JulianYG/WNR/documentation/Pictures/Untitled-3.png

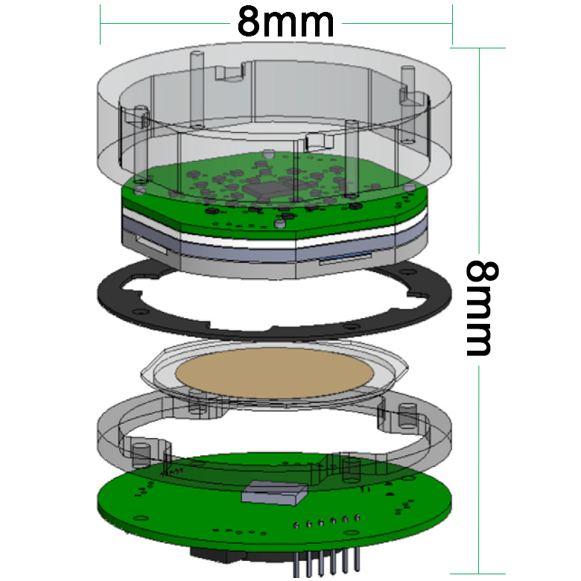
documentation/Pictures/Untitled-3.png
