JulianYG/WNR/documentation/Pictures/mockup.png

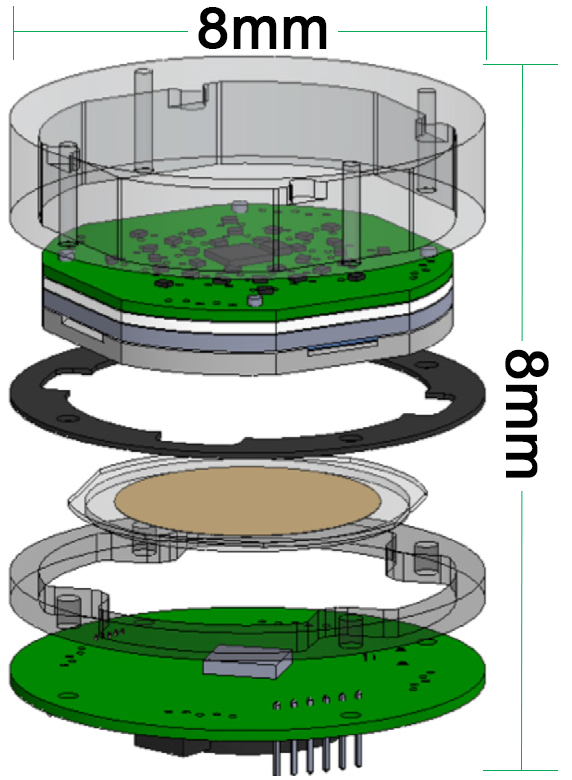
documentation/Pictures/mockup.png
