JulianYG/WNR/documentation/Pitches/Design Specifications.pptx

## Design Specifications

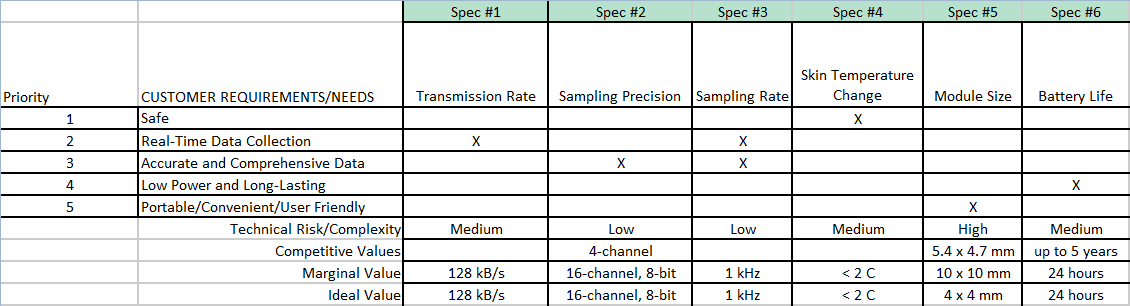
[picture p29: figure]

## Testing Methods

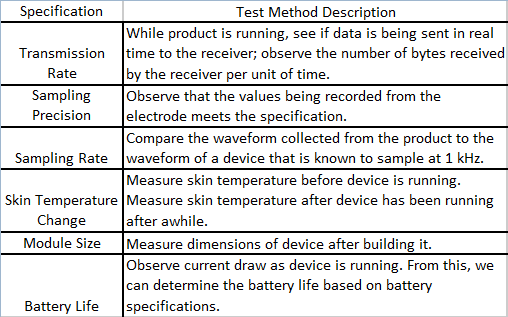
[picture p30: figure]

## System Diagram

## References

- http://www.neuropace.com/product/pdfs/UserManual.pdf
- Wireless Neural Recording with Single Low - Power Integrated Circuit (2010)
