JulianYG/WNR/documentation/Poster/Final Poster/WNR v6.pptx

Energy-Efficient High-Throughput Wireless Transmission of Multi-Channel Neural Signals

Wireless Neural Recorder - Senior Design Team
Yuan Gao, Xin Huang, Tingkai Liu, Stephen Xia
Department of Electrical and Computer Engineering, Rice University
ricewnr@gmail.com

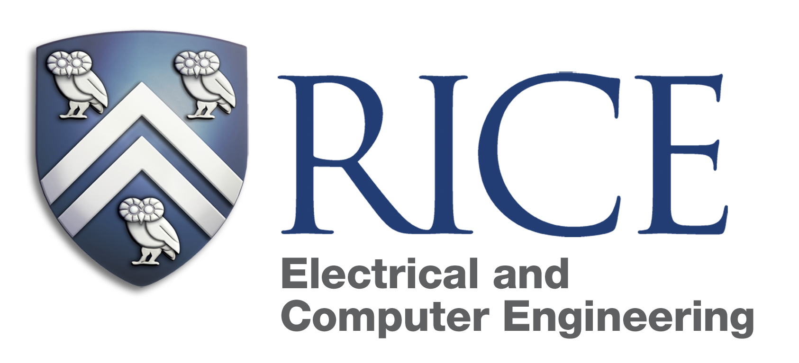
[picture p31: figure]

Project Description

Problem:
- Current Electrocochleography (ECoG) monitoring requires physical cables connected to brain to collect critical data for epilepsy diagnosis
- Lack of advanced wirelessly transmitting, implantable, monitoring devices hinder scientific progress and affect patient quality of life
System Design Goal:
- Create a compact, power-efficient, high-fidelity add-on cap to ECoG electrodes to wirelessly transmit neural data securely in real-time
Areas of Impact:
- Neurosurgeons & Hospitals – Simpler procedure and data monitoring
- Scientists & Research Institutions – Brain Machine Interface R&D
- Epilepsy Patients & their Families – Mobility and QOL improvement

Engineering Design for a Single WNR Cap

System Design Specifications

Design Requirements
Criteria | Target Value | Result
Data Channels | 16 Channels
Data Precision | 8 Bits
Sampling Frequency | 1000 Samples per Second
Form Factor | 15 x 15 x 15 mm
Battery Life | 12 Hours

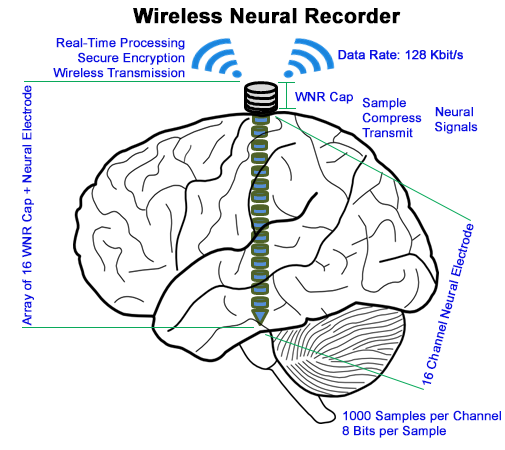
[picture p32: figure]

Neural Data

Neural Electrode
- 16 Data Channels
- 1K Samples/sec
- 8 Bits/Sample
Data: 128 Kbit/s

A2D Converter

Intan RHD2132
- Specialized Neural Recording with Protective Circuitry
- NanoVolt Data Sampling Precision

ARM Microprocessor

Nordic NRF52
- Powerful ARM Cortex-M4 Processor
- Data Buffering and Compression

Bluetooth Low Energy

Nordic NRF52
- 128 bit AES Encryption
- 1 Mbit/s Bandwidth
- < 6mA Power Consumption

Recording Server

Mobile Device
- Communicates with all WNR Caps
- Real-time Neural Data Collection and Presentation

WNR System

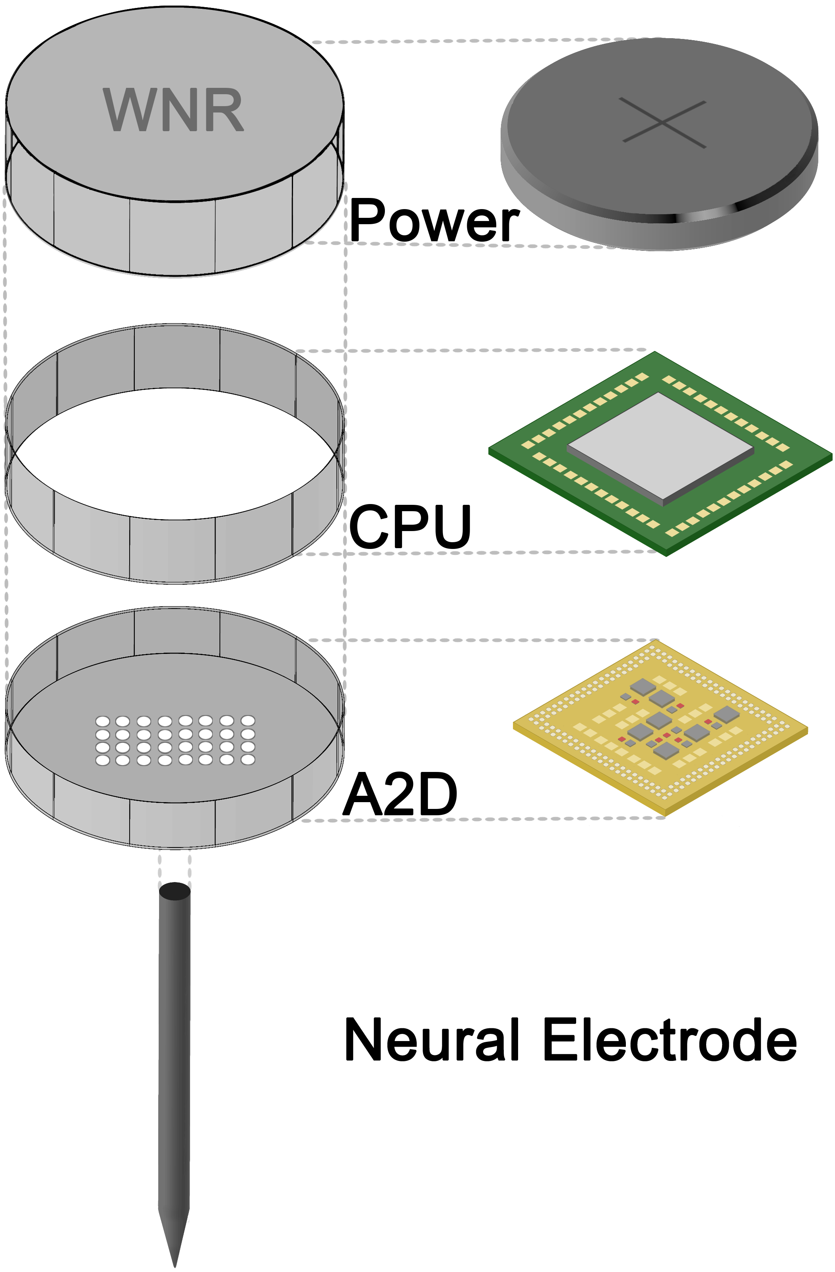
[picture p33: figure]

Conclusion

- Achieved goal of creating a compact, power-efficient, and precise Wireless Neural Recorder (WNR) and transmitter system, allowing neurosurgeons to obtain data while giving patients the freedom to move freely without being wired to a hospital bed

  - First generation system, with off-the-shelf components, achieves 50% data compression with sufficient excess compute power to integrate new software features such as epilepsy detection

Data:
- Available 32 Channel Sampling
- 1000 Samples per Second
- 8 Bit Data Precision

Small animal testing and data collection with functional prototype

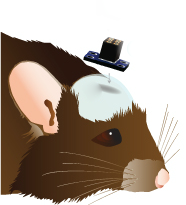
[picture p34: figure]

Power:
- Ultra-Low Power Consumption
- 12 Hour Battery Life
- 75mAh Off-the-Shelf Battery

Transmission:
- 1 Mbit/s Bandwidth
- 0.27 Mbit/s Throughput

Size & Safety:
- PCB size of 12x14 mm
- Integrated Protective Circuitry

Next Steps

Fabrication of custom components for smaller
8 x 8 x 8 mm design

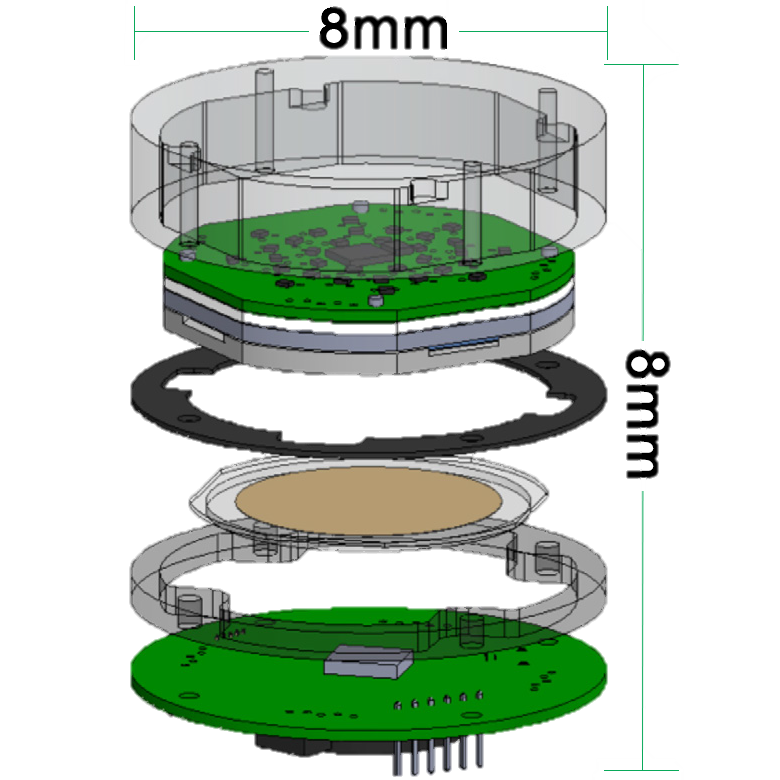
[picture p35: figure]

Utilize new WiFi HaLow for increased bandwidth, data rate, and data fidelity

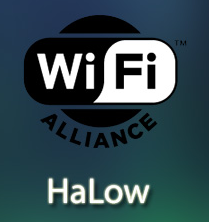
[picture p36: figure]

Expand WNR device to diagnose and monitor other diseases of the brain

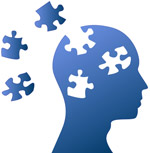
[picture p37: figure]

Acknowledgements

We would like to thank Rice ECE department members: Dr. Gary Woods, Dr. Aydin Babakhani, Hamed Rahmani and UTHealth Neurosurgeon: Dr. Nitin Tandon, for their technical advice and project support.
Special thanks to the Brenner Foundation with Ellen Kirk and the resources of the Oshman Engineering Design Kitchen.
