JulianYG/WNR/documentation/Minutes and Agendas/December 2015/reports/12-11 report.docx

WNR (Wireless Neural Recorder)

Rice University

Weekly Progress Report 13

12/4/2015 - 12/11/2015

Agenda for meetings

Cycle II Documentation Meeting:

1. Discuss new additions that are required
2. Divide up the documentation responsibility

Mentor Meeting:

1. Fall Design Review
  a. Recap on scope of project (design challenge, customer needs, etc.)
  b. Wireless Transmission
  c. Analog Front-End
  d. Compression
  e. Battery and Power

Activities this week

1. Analog Front-End:
  a. Discovered issue with reading in 0s.
    i. The number of pulses between Chip select pulses was not 16 (Intan sends 16-bits over SPI: 1 bit per pulse)
    ii. Must send data to the Intan Chip at the same time in order to read from the chip; otherwise no data is sent back
  b. Fed in data to the Intan Chip using a function generator with a voltage divider to characterize the chip.
    i. Fed data into one channel, but recorded data from all channels
  c. Measured and plotted power consumption
2. Wireless transmission:
  a. Discovered issue with stack initialization failure
    i. Jumper pins on the experimenter board were not configured correctly: every piece of documentation never mentioned this configuration except for the README file that came with the SDK that no one ever reads
  b. Bluetooth Connection Established
    i. Single slave to single master
    ii. Multiple slaves to single master
  c. Data Streaming Established
    i. Can stream from one slave to one master
    ii. Can also stream from two slaves to one master
  d. Transmission rate characterized
  e. Power consumption (current draw) measured
3. Compression:
  a. Comparison of MP3 compression and ALZ77 with Huffman Encoding

Problems encountered

1. Analog Front-End
  a. Intan Chip/entire circuit is extremely unreliable
    i. Sometimes the circuit would short for no apparent reason. The problem would fix itself after leaving the system alone for awhile.
  b. The signal read from the Intan Chip is extremely noisy
    i. This could be due to the fact that there are many wires in the development circuitry that are exposed to the air
    ii. Input voltages are driven really low by a normal resistor, which is noisy by itself
  c. Wrong values were being read from the Chip, though after a while, the issue seemed to resolve itself.
2. Wireless Transmission:
  a. Establishing Bluetooth link and streaming for one client and one master did not translate automatically into being able to do the same for multiple clients and one master
  b. Power consumption was difficult to measure because the MSP430F5438 experimenter board is a closed-circuit by itself
    i. Finally found a pin that can be used to measure current draw.
  c. MATLAB does not realistically calculate the data rate of the packets being received.
    i. Even though if packets are being sent over an interval of 10 seconds, the terminal program run from MATLAB is supposedly receiving all the packets within a period of less than one second. This makes the resulting data rate calculation be an order of magnitude greater than what the client actually sent.

Time devoted to project this week

Name | Tasks Accomplished | Hours Spent
Stephen Xia | - TI MSP430F5438 + TI CC2564 Bluetooth development - Cycle II Documentation | 80
Tingkai Liu | - Intan RHD2000 series analog front-end development - Cycle II Documentation | 72
Xin Huang | - Cycle II Documentation | 10
Yuan Gao | - Compression Characterization - Cycle II Documentation | 17
| Team Total | 179

Meetings Minutes

Cycle II Documentation Meeting – 12/7/2015, 1:00PM - 2:00 PM

Attendees: Stephen Xia, Tingkai Liu, Xin Huang, Yuan Gao

Location: Brochstein Pavilion

Completed objectives:

I. Cycle 1.5 Specifications are just the High Priority specifications that the fall design review will be graded on
II. Responsibilities of new documents
  A. Cycle III Functional Specs: Stephen Xia
  B. Testing Plan and Results: Yuan Gao
  C. IRB Information: Xin Huang
  D. Team Safety Plan: Thomas
  E. Design Foundation Revision: Xin Huang
  F. Design Strategy Revision: Stephen Xia
  G. Web Documentation: Xin Huang
  H. SVN Archives: Thomas
III. Prepare for fall design review on 12/10/2015 in the evening.

Mentor Meeting – 12/11/2015, 3:00PM - 5:00 PM

Attendees: Stephen Xia, Tingkai Liu, Xin Huang, Yuan Gao, Gary Woods, Hamed Rahmani, Nitin Tandon

Location: OEDK 104

Completed objectives:

I. Analog Front-End:
  A. Voltage rail issue resolved:
    1. The addition of the RHD2000 + LVDS converter was pulling the voltage supplied from the FreeScale Freedom board’s voltage to 0.
      a) Will power from an external power source
  B. 0s are still being read out
    1. SPI communication does not seem to be working still.
    2. Will try writing to the chip and observing what happens
II. Wireless Transmission
  A. Downgrading the IDE seems to have solved the issue of not being able to compile and load the demo code onto the boards.
  B. However, the demos don’t work because the MSP430F5438 cannot initialize the Bluetopia Bluetooth stack.
    1. upon further inspection, the MSP5438 does not seem to see the CC2564
  C. Will have to keep debugging; will have updates for the final design review.
III. Compression:
  A. The data received from Rakesh is very confusing
  B. Dr. Tandon looked at data and concludes that Rakesh has already processed the data.
    1. Dr. Tandon says he will get raw data to us in the next few days
IV. Items requested by Dr. Nitin Tandon
  A. Document of all the specifications, problems, and constraints.
    1. Include the calculation of power for all different specifications (e.g. what is power if we use Bluetooth, transmitting at 1 Mbps, etc.)
    2. Create an equation of power based on different frequency parameters
    3. Include a dream list or ideal list of specifications and parts

Expenditures

Action items list

Action item | Owner | Due date | Status
Research compression algorithms | Yuan Gao | 12/11/2015 | 75%
TI MSP430F5438 + TI CC2564 Bluetooth Development | Stephen Xia | 12/11/2015 | 70%
Intan RHD2000 series development | Tingkai liu | 12/11/2015 | 70%
Cycle Three Functional Specs | Stephen Xia | 12/14/2015 | 100%
Testing Plan and Results | Yuan Gao | 12/14/2015 | 100%
IRB Information | Xin Huang | 12/14/2015 | 100%
Team Safety Plan | Tingkai Liu | 12/14/2015 | 100%
Revisions to Previous Documents | Xin Huang | 12/14/2015 | 100%

Additional Comments/Questions for Mentors

- Dr. Tandon was actually able to turn up by 3:30 PM
- Dr. Woods had an appointment the previous day, so the meeting was pushed from 12/10/2015 to 12/11/2015
