JulianYG/WNR/documentation/Minutes and Agendas/December 2015/reports/12-3 report.docx

WNR (Wireless Neural Recorder)

Rice University

Weekly Progress Report 12

11/25/2015 - 12/3/2015

Agenda for meetings

Mentor Meeting:

1. Analog front-end updates with Intan Chip and LVDS converter.
2. Issues with MSP430F5438A in wireless communications.
3. Compression Updates

Activities this week

1. The wires on the Intan Adapter did not have pinouts, so we returned the adapter to Intan, who then shipped out the pinout adapter board.
2. Intan Chip power issue discovered and resolved.
  a. The Intan Chip + LVDS was pulling the voltage rail on the FreeScale Freedom board to ground.
    i. We are temporarily using the Freedom board for AFE development due to a lack of TI components and ease of use.
  b. For now, we will power the LVDS and Intan Chip from an external power supply
3. TI MSP430F5438 + TI CC2564 development is continuing.
  a. Changing IDE environments and re-downloading the SDK allows the code to compile and be loaded on the MCU
4. Received ECoG data from Rakesh; can test compression on live data.

Problems encountered

1. SPI communication with Intan Chip is still not working.
  a. Although the power issue is resolved, 0s are still only being read out.
2. TI CC2564 + TI MSP430F5438 Bluetopia Bluetooth SDK cannot be initialized on the MSP
  a. The error seems to stem from the fact that the MSP430F5438 does not seem to see the CC2564; however there are no leads as to why this is the case
  b. Will have to keep debugging and looking around.
  c. If this issue cannot be resolved in a timely manner, then we can switch to a simpler board for prototyping purposes.
3. ECoG data from Rakesh is very confusing and has many variables; we do not know which variable or file contains the actual data.

Time devoted to project this week

Name | Tasks Accomplished | Hours Spent
Stephen Xia | - TI MSP430F5438 + TI CC2564 Bluetooth development | 9
Tingkai Liu | - Intan RHD2000 series analog front-end development | 9
Xin Huang | - TI MSP430F5438 + TI CC2564 Bluetooth development | 4
Yuan Gao | - Huffman Encoding/Compression test and effectiveness characterization | 4
| Team Total | 26

Meetings Minutes

Mentor Meeting – 12/3/2015, 12:30PM - 1:30 PM

Attendees: Stephen Xia, Tingkai Liu, Xin Huang, Yuan Gao, Gary Woods, Hamed Rahmani, Nitin Tandon

Location: OEDK Big Classroom

Completed objectives:

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

Expenditures

- 1 x C3420 RHD2000 wire adapter for 36-pin connector (Returned): -$190
- 1 x C3410 RHD2000 electrode adapter board for 36-pin connector: $255
- Total: $65

Action items list

Action item | Owner | Due date | Status
Research compression algorithms | Yuan Gao | 12/11/2015 | 70%
TI MSP430F5438 + TI CC2564 Bluetooth Development | Stephen Xia | 12/11/2015 | 5%
Intan RHD2000 series development | Tingkai liu | 12/11/2015 | 10%

Additional Comments/Questions for Mentors

- Dr. Tandon mentions that he will not be able to attend the fall design review scheduled for next week.
