JulianYG/WNR/documentation/Minutes and Agendas/March 2016/reports/3-17 report.docx

WNR (Wireless Neural Recorder)

Rice University

Weekly Progress Report 22

3/11/2016 - 3/17/2016

Agenda for meetings

Mentor Meeting:

1. PCB Issues
2. Issues with Merging Subsystems

Activities this week

1. Most of PCB design is finished
2. Merging Subsystems

Problems encountered

1. Spacing is very tight on PCB
2. Difficulty in combining compression and spi reading with event handler

Time devoted to project this week

Name | Tasks Accomplished | Hours Spent
Stephen Xia | - Merging Subsystems | 15
Tingkai Liu | - Intan PCB Design | 15
Xin Huang | - Nordic PCB Design | 15
Yuan Gao | - Merging Subsystems | 10
| Team Total | 55

Meetings Minutes

Weekly Meeting – 3/17/2016, 12:00PM - 1:00 PM

Attendees: Stephen Xia, Tingkai Liu, Xin Huang, Yuan Gao, Gary Woods

Location: OEDK 104

Completed objectives:

I. Battery:
  A. P13: doesn’t work:
    1. Less than 3.0 V
  B. Alternatives:
    1. Larger pr44 that has enough voltage is too big (the battery holder) to fit on board with the jumpers
    2. Could make custom battery holder
    3. Or smush parts together
II. Nordics out of stock
  A. Order older revisions
III. Revisions and finalize PCB:
  A. Reduce spacing between pins
IV. Nordic: merging subsystems
  A. Trying to get event handler to do compression and read at the same time; may take a while
  B. Eventually will need to add ble

Expenditures

- N/A

Action items list

Action item | Owner | Due date | Status
Nordic PCB Design | Xin Huang | 4/14/2016 | 60%
Intan PCB Design | Tingkai Liu | 4/14/2016 | 60%
Combine compression, spi, and transmission | Stephen | 4/14/2016 | 20%
Server/Receiver | Yuan Gao | 4/14/2016 | 10%

Additional Comments/Questions for Mentors
