JulianYG/WNR/documentation/Minutes and Agendas/October 2015/reports/10-29 report.docx

WNR (Wireless Neural Recorder)

Rice University

Weekly Progress Report 8

10/23/2015 - 10/29/2015

Agenda for meetings

Mentor Meeting:

1. Go over power consumption and bandwidth feasibility with Dr. Tandon
2. CC2650 wireless transmission updates
3. Discuss how to pay for the Intan Chip using funds from two different sources
4. Discuss how to obtain intracranial EEG data

Activities this week

1. Continue development of wireless transmission scheme using CC2650 and Nordic Labs boards

Problems encountered

1. Working on CC2650 is still slow; still trying to understand code and documentation
2. Nordic Labs SDK still not set up

Time devoted to project this week

Name | Tasks Accomplished | Hours Spent
Stephen Xia | - CC2650 BLE development | 5
Tingkai Liu | - Confirm Intan Chip specifications and costs - CC2650 BLE development | 5
Xin Huang | - Finish battery research - Nordic Board BLE development | 5
Yuan Gao | - Nordic Board BLE development | 5
| Team Total | 20

Meetings Minutes

Mentor Meeting – 10/29/2015, 12:30PM - 1:30 PM

Attendees: Stephen Xia, Tingkai Liu, Xin Huang, Yuan Gao, Gary Woods, Hamed Rahmani

Completed objectives:

I. Dr. Tandon did not show up, so we did not present our power and bandwidth feasibility
II. Buying the Intan Chip:
  A. Require funding from two sources (ECE department and OEDK)
    1. We can place the order in one department and transfer funds between departments
III. CC2650:
  A. Figured out the general framework of CC2650
  B. Aim to have something custom transmitting next week
  C. Probably has enough memory to run a compression algorithm
IV. EEG Data:
  A. No response from Dr. Tandon or Behnaam
    1. Talk to them directly or their graduate students, who should have data
V. Compile a list of questions to ask Dr. Tandon
  A. How low can we sample the data?
    1. Most papers only display up to 30 Hz on the spectrum
    2. If we lower the sampling rate to around 250 Hz, we can get the data rate to around 0.5 Mb/s, which is supported by BLE.
      a) Otherwise, we may have to heavily compress the data
  B. Can we get physical needle?
VI. FOSS II Goals:
  A. Characterize maybe only one environment
  B. Possibly require an error correction mechanism (TCP or error correction code)
VII. For Next Time:
  A. Order the Intan AFE Chip
  B. Create Slides for Dr. Tandon next week
  C. Obtain EEG data and run compression algorithms to test efficiency
  D. Get transmission and incorporate Intan Chip

Expenditures

- N/A

Action items list

Action item | Owner | Due date | Status
Survey analog front-end chips for neural recording | Tingkai Liu | 10/29/2015 | 100%
Research analog front-end circuits for high SNR amplification | Stephen Xia | 10/29/2015 | 100%
Battery module research/survey | Xin Huang | 10/23/2015 | 100%
Intan Chip/Analog front-end power consumption research | Tingkai Liu | 10/23/2015 | 50%
Wireless transmission power consumption research | Stephen Xia | 10/23/2015 | 50%
Research compression algorithms | Yuan Gao | 10/23/2015 | 30%
CC2650/CC2640 BLE Development | Xin Huang | 10/23/2015 | 40%
Nordic Labs BLE Development | Tingkai Liu | 11/04/2015 | 10%

Additional Comments/Questions for Mentors
