JulianYG/WNR/documentation/Cycle II Documentation/web_documentation_cycle2.pdf

12/14/2015 | OEDK Rice University Member public profile

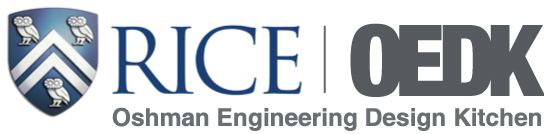
[picture p52: figure]

http://oedk.rice.edu/Sys/PublicProfile/29809194/1063096 | 1/3
Events (http://oedk.rice.edu/events) | News (http://oedk.rice.edu/news) | FAQs (http://oedk.rice.edu/faqs) | Get Involved (http://oedk.rice.edu/getinvolved)
Enter search string |

Membership level

Team Name

Project Title

Design Challenge

Project Thumbnail Image

Date Updated

Sponsors

Department(s)

Faculty Advisor 1 - Name

Faculty Advisor 1 - Department

Faculty Advisor 2 - Name

Faculty Advisor 2 - Department

Rapid Prototyping Tools Used

Back (http://oedk.rice.edu/projects)

# WNR

# Wireless Relay of Multi-Channel Neuro-Electrode Data

Send message

2015-2016 Team

WNR

Wireless Relay of Multi-Channel Neuro-Electrode Data

Currently, no solution exists on the market for an efficient recording of neural brain activity that is not restricted by a physical tether. Our project goal is to develop a low-power wireless recording device that digitizes neural signals from a 16-channel, 16-element electrode array and send the neural data wirelessly to a portable receiver. The wireless neural recorder will first be wireless embedded ECoG system implemented in animals and eventually humans.

Sunday, December 13, 2015

Brenner Foundation with Ellen Kirk

Electrical and Computer Engineering

Gary Woods

ECE

Aydin Babakhani

ECE

PCB Mill
Reflow Oven
Soldering Station
Oscilloscope

Facilities Used

Electronic Tools Used

Software Used

PROPER ACKNOWLEDGMENT:

Hand Tools

Conference Rooms
Computer Lab or Computer Nook Specialty Software
Printers/ Copiers
Electronics Lab or Tools from Electronics Lab

TI Microcontroller (MSP 430)
TI DSP Chip (eg C2000)
Arduino
ARM
Hand assembled Protoboard/perf board Prefabricated PCB (eg evaluation modules, LaunchPAd FPGA
Freescale
LED
LCD display
Digital Multi-meter

C
C++
Matlab
Eagle
Code Composer

This project was sponsored by Brenner Foundation with Ellen Kirk. The design work for this project was supported by the resources of the Oshman Engineering Design Kitchen.

# Member photo albums (2 Albums)

Team Photo Album (3) (http://oedk.rice.edu/Sys/PublicProfile/29809194/PhotoAlbums/46020854) | Team Photo Album 2 (5) (http://oedk.rice.edu/Sys/PublicProfile/29809194/PhotoAlbums/47834308)

# ABOUT

Mission (http://oedk.rice.edu/what)
Our Team (http://oedk.rice.edu/people)
Visit the OEDK (http://oedk.rice.edu/where)
Curriculum (http://oedk.rice.edu/curriculum)
Immersion (http://oedk.rice.edu/immersion)
Programs (http://oedk.rice.edu/programs)

# QUICK LINKS

Current Projects (http://oedk.rice.edu/projects)
Award Winning Projects (http://oedk.rice.edu/winners)
Project Videos (http://oedk.rice.edu/videos)
Project Sponsors - coming soon Tour Request (http://oedk.rice.edu/tour)
Safety Guidelines (http://oedk.rice.edu/safetyguidelines)

# RICE PARTNERS

Rice University Homepage (http://www.rice.edu/)
Brown School of Engineering (http://engr.rice.edu/) Rice Center for Engineering Leadership (http://rcel.rice.edu/)
Beyond Traditional Borders (http://www.rice360.rice.edu/btb)
Rice 360˚ Institute for Global Health (http://www.rice360.rice.edu/)

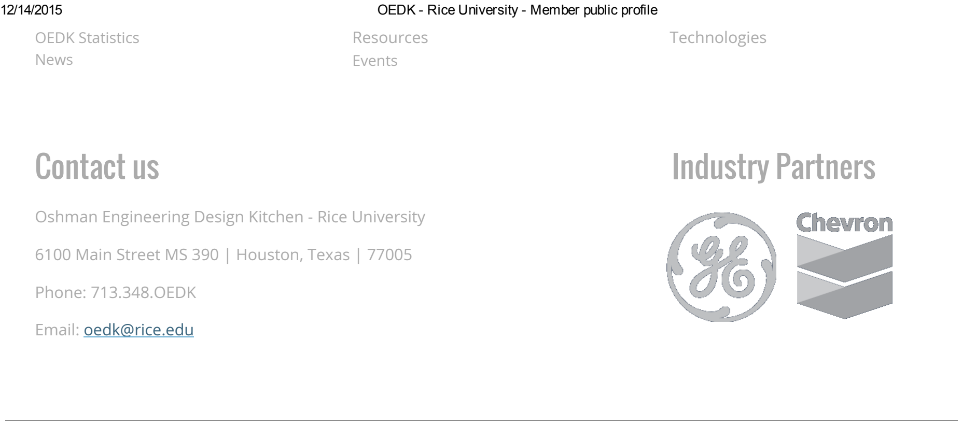
[picture p53: figure]
OEDK Statistics News; Resources Events; Technologies; Contact us; Phone: 713.348.OEDK; Email: oedk@rice.edu; Industry Partners

Oshman Engineering Design Kitchen - Rice University

6100 Main Street MS 390 | Houston, Texas | 77005

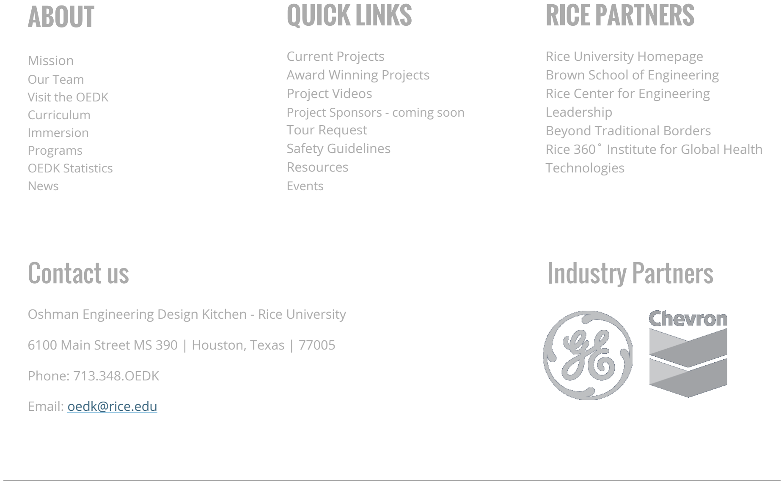
[picture p54: figure]
ABOUT; Mission Our Team Visit the OEDK Curriculum Immersion Programs OEDK Statistics News; QUICK LINKS; Current Projects Award Winning Projects Project Videos Project Sponsors - coming soon Tour Request Safety Guidelines Resources Events; RICE PARTNERS; Rice University Homepage Brown School of Engineering Rice Center for Engineering Leadership Beyond Traditional Borders Rice 360˚ Institute for Global Health Technologies; Contact us; Phone: 713.348.OEDK; Email: oedk@rice.edu; Industry Partners

http://oedk.rice.edu/Sys/PublicProfile/29809194/PhotoAlbums/47834308 | 1/1
Events (http://oedk.rice.edu/events) | News (http://oedk.rice.edu/news) | FAQs (http://oedk.rice.edu/faqs) | Get Involved (http://oedk.rice.edu/getinvolved)
Enter search string |

Back (http://oedk.rice.edu/Sys/PublicProfile/29809194/1063096)

# Team Photo Album 2 (5)

Created on: Sunday, December 13, 2015

Cycle 2

Oshman Engineering Design Kitchen - Rice University

6100 Main Street MS 390 | Houston, Texas | 77005
