JulianYG/WNR/documentation/Cycle II Documentation/Functional Specifications Cycle III.xlsx

Team: WNR
Stephen Xia
Tingkai Liu
Yuan Gao
Xin Huang
Cycle III: Functional Specifications
 |  | Spec #1 | Spec #2 | Spec #3 | Spec #4 | Spec #5 | Spec #6 | Spec #7 | Spec #8
Priority | CUSTOMER REQUIREMENTS/NEEDS | Transmission Rate | Sampling Precision | Sampling Rate | Skin Temperature Change | Module Size | Battery Life | Operable Range | DC Offset
1 | Safe |  |  |  | X |  |  |  | X
2 | Real-Time, Accurate, and Reliable | X | X | X |  |  |  |  | X
3 | Portable/Convenient/Low Power |  |  |  |  | X | X | X
 | Technical Risk/Complexity | Medium | Low | Low | Medium | High | Medium | Medium | Medium
 | Competitive Values | 15 Mb/s | 64-channel, 10-bit | 100 kHz | < 2 C / 3.6 F | 5.4 x 4.7 mm | up to 5 years | 4 meters | 1 - 2 V | TOTALS (Should sum to 2000 with Cycle 4/5 objectives)
 | Marginal Value | 128 kb/s/electrode | 16-channel, 8-bit | 1 kHz | < 2 C / 3.6 F | 10 x 10 mm | 6 hours | 2 meters | 0 - 2 V
 | Ideal Value | 256 kb/s/electrode | 16-channel, 16-bit | 1 kHz | < 1 C / 1.8 F | 4 x 4 mm | few years | 4 meters | 0 - 1 V
 | Final Measured Value (Cycle 5)
 | Potential Point Value (Students Enter) |  |  |  |  |  |  |  |  | 0
 | Graded Point Value (Profs Enter) |  |  |  |  |  |  |  |  | 0
Objectives for Cycle III
Related Specifications | Objective |  |  |  | Potential Points (<300) | Graded Points
Spec 1, 2, 3, 6 | 1. Analog Front-End & Bluetooth
 | 1.1. Read data from SPI |  |  |  | 400
 | 1.2. Buffer read data and continuously transmit buffered data from at least two wireless chips (peripherals) to a receiver at the same time |  |  |  | 400
 | 1.3. Measure power consumption of running the wireless transmission component and data pre-processing at the same time, transmitting at 1000 samples/s/channel for at least 16 channels (16,000 samples/s total) |  |  |  | 200
Spec 2, Spec 3, Spec 6 | 2. Server End
 | 2.1. Receive data packet from at least two wireless chips within operable range, potentially perform error correction |  |  |  | 500
 | 2.2. Marshal the data by parsing headers and footers in real time (order the data received into sequence based on time stamp and probe header) |  |  |  | 200
 | 2.3. Generate real time plot and/for display |  |  |  | 150
Spec 1 | 3. Compression and Data Analysis
 | 3.1. Implement the ALZ77 compression algorithm on microcontroller and evaluate feasibility |  |  |  | 150
 | TOTAL |  |  |  | 2000
