JulianYG/WNR/documentation/Cycle III Documentation/K_EngineeringDrawings_WNR_Cycle 3.docx

Figure 1. System Block Diagrams which shows each component of the complete system

Figure 2. nRF52 memory map.

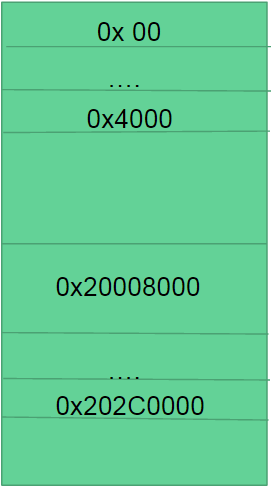
[picture p55: figure]

ROM: 0x0 - 0x4000, RAM: 0x20008000 - 0x202C0000

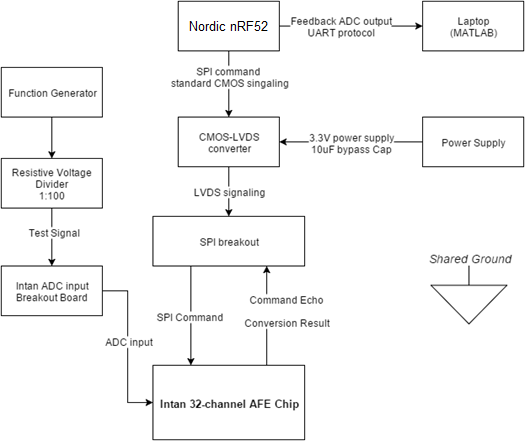
[picture p56: figure]

Figure 3. Complete System Setup for configuration and testing of Intan RHD2132 Analog-Front-End Chip
