JulianYG/WNR/documentation/Cycle III Documentation/Intan32_powerconsumption.png

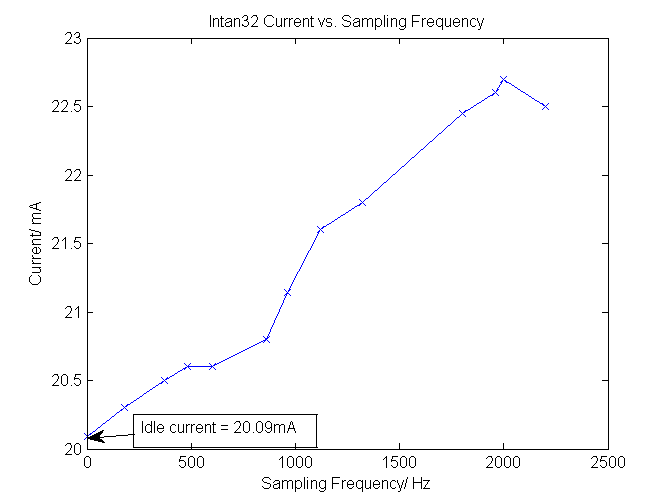
documentation/Cycle III Documentation/Intan32_powerconsumption.png
