JulianYG/WNR/documentation/Pictures/a32.png

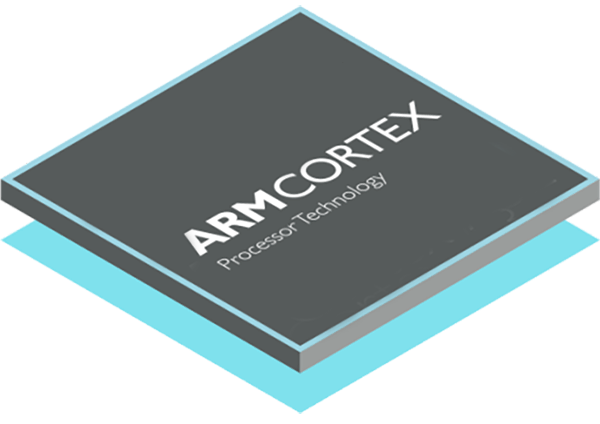
documentation/Pictures/a32.png
