JulianYG/WNR/documentation/Pictures/graphic.png

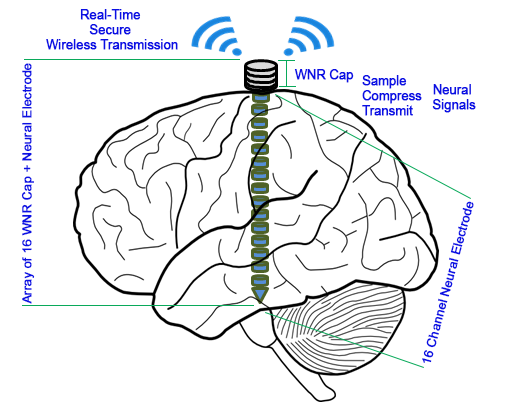
documentation/Pictures/graphic.png
