JulianYG/WNR/documentation/Pictures/Untitled-1.png

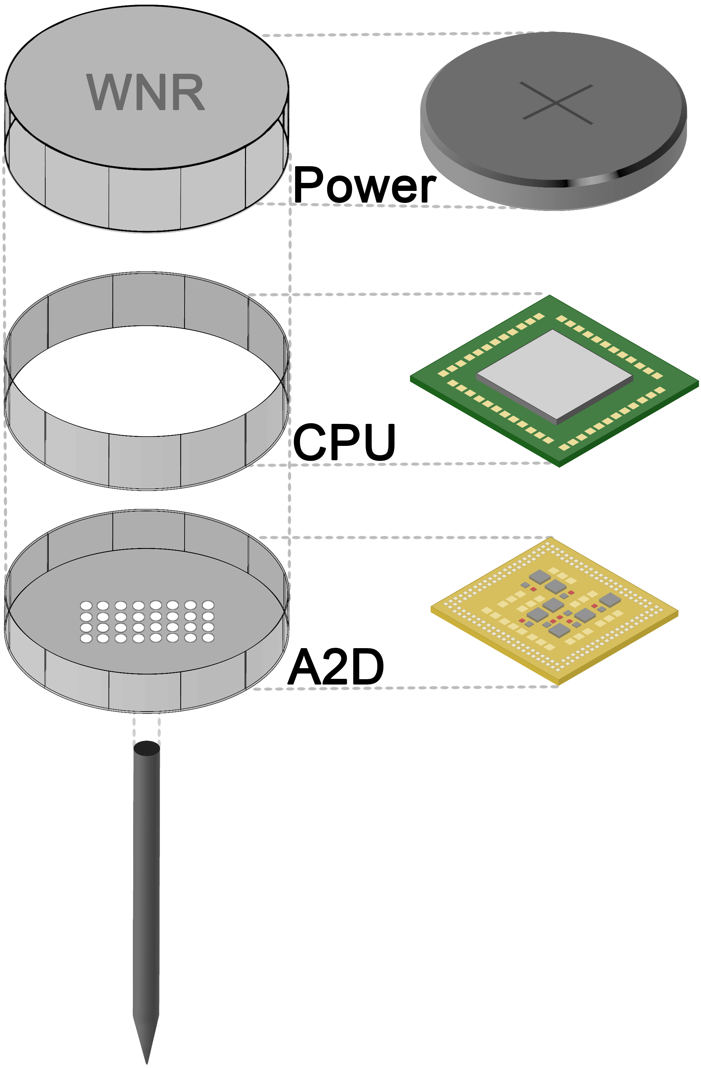
documentation/Pictures/Untitled-1.png
