JulianYG/WNR/documentation/Pictures/Xin project prototype 3 (transparent).png

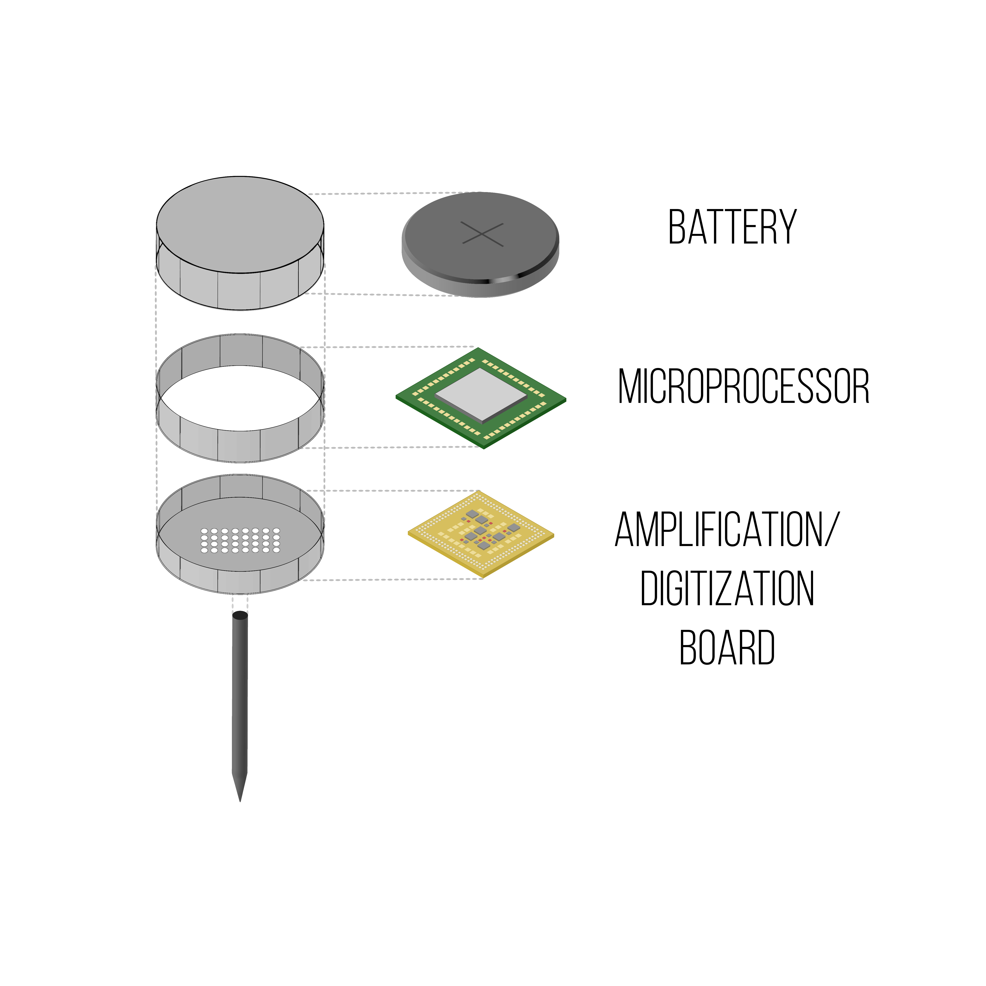
documentation/Pictures/Xin project prototype 3 (transparent).png
