JulianYG/WNR/documentation/Equipment _ Parts/BLE Parts.docx

BLE FAQ

http://processors.wiki.ti.com/index.php/BLE_-_FAQ

Product matrix:

https://www.broadcom.com/collateral/hs/2073X-HS100-R.pdf

https://www.broadcom.com/products/wireless-connectivity/bluetooth/bcm20702

https://www.broadcom.com/collateral/pb/MMP20736-PB101-R.pdf
