JulianYG/WNR/documentation/Budget/Inventory Tracker.xlsx

ITEM | COST | QUANTITY | TOTAL COST | Total Budget | Total Spend | Remaining Balance
nRF52-preview-DK | $71.25 | 4 | $285.00 | $2500 | $662.40 | $1,838
60 Power One Size 312 MERCURY FREE | $16.95 | 1 | $16.95
60 Powerone Mercury Free Hearing Aid Batteries Size: 13 | $17.45 | 1 | $17.45
CC-DEVPACK-DEBUG | $15 | 1 | $15
CC2650DK | $299 | 1 | $299
CC2650STK | $29 | 1 | $29
