JulianYG/WNR/documentation/Budget/Purchase _ Expend.xlsx

ITEM | Vendor | Unit Price | Quantity | Purchase Cost | Shipping Cost | Total Cost | Running Balance | Available Fund
nRF52 preview Nordic Development Kit | Mouser Electronics | 71.25 | 4 | 285 | 0 | 285 | -285 | 2215
60 Power One Size 312 Mercury Free Battery | Amazon | 17.45 | 1 | 17.45 | 0 | 17.45 | -17.45 | 2197.55
60 Power One Mercury Free Hearing Aid Battery | Amazon | 16.95 | 1 | 16.95 | 0 | 16.95 | -16.95 | 2180.6
TI CC DEVPACK-DEBUG | Mouser Electronics | 15 | 1 | 15 | 0 | 15 | -15 | 2165.6
TI CC2650 Development Kit | Mouser Electronics | 299 | 1 | 299 | 6.99 | 305.99 | -305.99 | 1859.61
TI CC2650 Software Tool Kit | Mouser Electronics | 29 | 1 | 29 | 0 | 29 | -29 | 1830.61
C3206 RHD2000 6-ft (1.8 m) Standard SPI interface cable | INTAN Technologies, LLC | 295 | 1 | 295 | 0 | 295 | -295 | 1535.61
C3314 RHD2132 amplifier board with 32 unipolar inputs | INTAN Technologies, LLC | 895 | 1 | 895 | 0 | 895 | -895 | 640.61
C3420 RHD2000 wire adapter for 36-pin connector | INTAN Technologies, LLC | 190 | 1 | 190 | 0 | 190 | -190 | 450.61
C3430 RHD2000 SPI cable adapter board | INTAN Technologies, LLC | 98 | 1 | 98 | 0 | 98 | -98 | 352.61
Intan Shipping & Handling | Federal Express | 0 | 1 | 0 | 33.85 | 33.85 | -33.85 | 318.76
Texas Instruments SN65LVDT41QPWREP | DigiKey | 6.95 | 3 | 20.85 | 0 | 20.85 | -20.85 | 297.91
595-CC2564MODNEM | Mouser Electronics | 19.99 | 3 | 59.97 | 0 | 59.97 | -59.97 | 237.94
595-MSP-EXP430F5438 | Mouser Electronics | 175 | 3 | 525 | 0 | 525 | -525 | -287.06
BOB-00495 | Sparkfun Electronics | 3.95 | 4 | 15.8 | 0 | 15.8 | -15.8 | -302.86
C3420 RHD2000 wire adapter for 36-pin connector - Return | INTAN Technologies, LLC | -190 | 1 | -190 | 10 | -180 | 180 | -122.86
C3410 RHD2000 electrode adapter board for 36-pin connector | INTAN Technologies, LLC | 255 | 1 | 255 | 13.47 | 268.47 | -268.47 | -391.33
nRF52 Nordic Development Kit | Mouser Electronics | 71.25 | 5 | 356.25 | 0 | 356.25 | -356.25 | -747.58
nRF51 Nordic Development Kit | Mouser Electronics | 71.25 | 2 | 142.5 | 0 | 142.5 | -142.5 | -890.08
Cypress CY5670 BLE Dongle | Mouser Electronics | 16.88 | 2 | 33.76 | 0 | 33.76 | -33.76 | -923.84
nRF51 Nordic BLE Dongle | Mouser Electronics | 48.75 | 2 | 97.5 | 0 | 97.5 | -97.5 | -1021.34
NRF52832-QFAA-T-BXO | Semiconductor Store | 2.83 | 6 | 16.98 | 0 | 114.48 | -114.48 | -1135.82
25ct 393 Battery | Amazon | 28.88 | 1 | 28.88 | 0 | 28.88 | -28.88 | -1164.7
614-393-0HG | Mouser Electronics | 1.35 | 10 | 13.5 | 0 | 13.5 | -13.5 | -1178.2
SN65LVDT41PW | Mouser Electronics | 6.82 | 2 | 13.64 | 0 | 13.64 | -13.64 | -1191.84
2450AT18B100E | Mouser Electronics | 0.58 | 15 | 8.7 | 0 | 22.34 | -22.34 | -1214.18
2989 Keystone Electronics | Mouser Electronics | 0.32 | 24 | 7.68 | 0 | 7.68 | -7.68 | -1221.86
500R07S120GV4T | Mouser Electronics | 0.12 | 100 | 12 | 0 | 12 | -12 | -1233.86
GJM1555C1HR80WB01D | Mouser Electronics | 0.12 | 25 | 3 | 0 | 3 | -3 | -1236.86
530L104KT16T | Mouser Electronics | 2.03 | 35 | 67.97 | 0 | 67.97 | -67.97 | -1304.83
CAP CER 10000PF 25V X7R 0402 | DigiKey | 0.11 | 15 | 1.65 | 0 | 1.65 | -1.65 | -1306.48
CAP CER 0.1UF 25V X7R 0402 | DigiKey | 0.13 | 20 | 2.6 | 0 | 2.6 | -2.6 | -1309.08
CAP CER 100PF 25V NP0 0402 | DigiKey | 0.39 | 20 | 7.8 | 0 | 7.8 | -7.8 | -1316.88
CAP CER 4.7UF 6.3V X5R 0603 | DigiKey | 0.16 | 25 | 4 | 0 | 4 | -4 | -1320.88
CAP CER 1UF 10V X7R 0603 | DigiKey | 0.25 | 20 | 5 | 0 | 5 | -5 | -1325.88
FIXED IND 3.9NH 840MA 66 MOHM | DigiKey | 0.3 | 10 | 3 | 0 | 3 | -3 | -1328.88
FIXED IND 3.9NH 840MA 66 MOHM | DigiKey | 0.58 | 5 | 2.9 | 0 | 2.9 | -2.9 | -1331.78
FIXED IND 10UH 300MA 600 MOHM | DigiKey | 0.15 | 15 | 7.5 | 0 | 7.5 | -7.5 | -1339.28
FIXED IND 15NH 560MA 172 MOHM | DigiKey | 0.61 | 5 | 3.05 | 0 | 3.05 | -3.05 | -1342.33
FIXED IND 15NH 560MA 170 MOHM | DigiKey | 0.3 | 10 | 3 | 0 | 3 | -3 | -1345.33
RHD2132 32-channel amplifier digital-output chip | INTAN Technologies, LLC | 390 | 2 | 680 | 0 | 680 | -680 | -2025.33
WNR PCB Design | 4pcb | 33 | 2 | 66 | 70.12 | 136.12 | -136.12 | -2161.45
EPSON FA-128 32.0000MF20X-K3 Crystal | DigiKey | 0.97 | 20 | 19.4 | 0 | 19.4 | -19.4 | -2180.85
BMD-200-B-R | DigiKey | 15.21 | 3 | 45.63 | 0 | 45.63 | -45.63 | -2226.48
GJM1555C1H1R2WB01D | DigiKey | 0.12 | 50 | 6 | 0 | 6 | -6 | -2232.48
SMT BREAKOUT PCB 48QFN/TQFP 3PK | DigiKey | 5.95 | 2 | 11.9 | 0 | 11.9 | -11.9 | -2244.38
Rigado BMD-300-A-R | DigiKey | 11.71 | 5 | 58.55 | 0 | 58.55 | -58.55 | -2302.93
CX2016DB32000D0WZRC1 | DigiKey | 0.61 | 10 | 6.1 | 0 | 6.1 | -6.1 | -2309.03
ST3215SB32768E0HSZB1 | DigiKey | 0.73 | 10 | 7.3 | 0 | 7.3 | -7.3 | -2316.33
ECS-.327-12.5-12L-TR | DigiKey | 1.34 | 5 | 6.7 | 0 | 6.7 | -6.7 | -2323.03
APG1005VGC-T-5MAV | DigiKey | 0.41 | 25 | 10.25 | 0 | 10.25 | -10.25 | -2333.28
