JulianYG/WNR/documentation/Cycle IV Documentation/N_BillOfMaterials_WNR_Cycle4.xlsx

Sheet: NRF52
Designator | Value | Description | Footprint | PRODUCT | LINK
C1, C2 | 12 pF | Capacitor, NP0, ±2% | 0402 | Johanson 500R07S120GV4T | http://www.mouser.com/Search/ProductDetail.aspx
C3 | 0.8 pF | Capacitor, NP0, ±5% | 0403 | Murata GJM1555C1HR80WB01D | http://www.mouser.com/Search/ProductDetail.aspx
C4, C5, C8 | 100 nF | Capacitor, X7R, ±10% | 0404 | ATC 530L104KT16T | http://www.mouser.com/Search/ProductDetail.aspx
C6 | N.C. | Not mounted | 0405
C7 | 100 pF | Capacitor, NP0, ±5% | 0406 | Kemet CBR04C101F3GAC | http://www.digikey.com/scripts/DkSearch/dksus.dll?Detail&itemSeq=192454444&uq=635960629680137746
C9 | 4.7 µF | Capacitor, X5R, ±10% | 0603 | Johanson 6R3R14X475KV4T | http://www.digikey.com/scripts/DkSearch/dksus.dll?Detail&itemSeq=192454549&uq=635960629680147746
C10 | 1.0 µF | Capacitor, X7R, ±10% | 0604 | TDK CGJ3E2X7R1A105K080AA | http://www.digikey.com/scripts/DkSearch/dksus.dll?Detail&itemSeq=192454557&uq=635960629680147746
L1 | 3.9 nH | High frequency chip inductor ±5% | 0402 | Abracon AISC-0402-3N9J-T | http://www.digikey.com/scripts/DkSearch/dksus.dll?Detail&itemSeq=192454664&uq=635960629680147746
L2 | 10 µH | Chip inductor, IDC,min = 50 mA, ±20% | 0603 | TDK MLZ1608N100LT000 | http://www.digikey.com/scripts/DkSearch/dksus.dll?Detail&itemSeq=192454709&uq=635960629680157746
L3 | 15 nH | High frequency chip inductor ±10% | 0402 | Abracon AISC-0402-15NJ-T | http://www.digikey.com/scripts/DkSearch/dksus.dll?Detail&itemSeq=192454742&uq=635960629680167746
U1 | nRF52832-QFAA | Multi-protocol Bluetooth low energy and 2.4 GHz proprietary system on chip | QFN-48 | NRF52832-QFAA-T-BXO | http://www.semiconductorstore.com/cart/pc/viewPrd.asp?idproduct=61462
X1 | 32 MHz | XTAL SMD 2016, 32 MHz, Cl=8 pF, Total Tol: ±40 ppm | XTAL_2016 | EPSON FA-128 32.0000MF20X-K3 | http://www.digikey.com/scripts/DkSearch/dksus.dll?Detail&itemSeq=194414069&uq=635960637082237746
ANT | 2.4GHZ | 2.4GHZ Antenna | ANT | Johanson 2450AT18B100E | http://www.mouser.com/Search/ProductDetail.aspx
8 Header | 8 pins | 8 Pin .050" Micro Low Profile Terminal Strip | 8 Pin | Samtec FTS-108-01-S | https://www.samtec.com/products/fts
1 Header | 1 pin | 1 Pin .050" Micro Low Profile Terminal Strip | 1 Pin | Samtec FTS-101-01-S | https://www.samtec.com/products/fts

Sheet: Intan
Designator | Value | Description | Footprint | PRODUCT | LINK
U1 | Intan RHD2132 | Intan 32 Channel A2D | QFN56 | RHD2132 | http://intantech.com/pricing.html
C1, C2 | 100nF | 100nF 0402 X5R/X7R 16V Capacitor | 0402 | TDK CGJ2B3X7R1E104K050BB | http://www.digikey.com/product-detail/en/tdk-corporation/CGJ2B3X7R1E104K050BB/445-13302-1-ND/3954968
C3 | 10nF | 10nF 0402 X5R/X7R 16V Capacitor | 0402 | TDK CGJ2B2X7R1E103K050BA | http://www.digikey.com/product-detail/en/tdk-corporation/CGJ2B2X7R1E103K050BA/445-8078-1-ND/2812109
8 Header | 8 pins | 8 Pin .050" Micro Low Profile Terminal Strip | 8 Pin | Samtec FTS-108-01-S | https://www.samtec.com/products/fts

Sheet: Battery Board
Designator | Value | Description | Footprint | PRODUCT | LINK
Battery Holder | 2989 | Keystone 2989 7.9mm battery holder | 7.9mm Holder | Keystone 2989 Header | http://www.mouser.com/Search/ProductDetail.aspx?R=2989virtualkey53400000virtualkey534-2989
Battery | Power | 7.9mm Silver Oxide battery | 7.9mm battery | Renata 393.MP 0% HG | http://www.mouser.com/Search/ProductDetail.aspx
1 Header | 1 pin | 1 Pin .050" Micro Low Profile Terminal Strip | 1 Pin | Samtec FTS-101-01-S | https://www.samtec.com/products/fts
