JulianYG/WNR/documentation/Cycle IV Documentation/N_LaborBurden_MaterialCostAnalysis_WNR_Cycle4.xlsx

Labor, Burden and Materials (LBM) Cost Analysis
 | Burdened Labor Rate: | $20.00 | per hour Assemble Phase
 |  | $35.00 | per hour Testing Phase
 | Process Step | Material | Quantity | Material Cost | # of people | Duration of Task (hrs) | Labor Cost | Notes
 | Assemble Nordic Board | Capacitor, NP0, ±2%, 0402 | 2 | $1.65 | 1 | 4 | $80.00
 |  | Capacitor, NP0, ±5%, 0403 | 1 | $2.60
 |  | Capacitor, X7R, ±10%, 0404 | 3 | $5.00
 |  | Capacitor, NP0, ±5%, 0405 | 1 | $1.65
 |  | Capacitor, X5R, ±10%, 0406 | 1 | $4.00
 |  | Capacitor, X7R, ±10%, 0603 | 1 | $7.80
 |  | High frequency chip inductor ±5% | 1 | $3.00
 |  | Chip inductor, IDC,min = 50 mA, ±20% | 1 | $7.50
 |  | High frequency chip inductor ±10% | 1 | $3.05
 |  | Multi-protocol Bluetooth low energy and 2.4 GHz proprietary system on chip | 1 | $16.98
 |  | XTAL SMD 2016, 32 MHz, Cl=8 pF, Total Tol: ±40 ppm | 1 | $19.40
 |  | 2.4GHZ Antenna | 1 | $8.70
 |  | 8 Pin .050" Micro Low Profile Terminal Strip | 1 | $0.00 |  |  |  | Sampled w/o cost
 |  | 1 Pin .050" Micro Low Profile Terminal Strip | 1 | $0.00 |  |  |  | Sampled w/o cost
 | Nordic Board Testing | Function Generator | 1 |  | 2 | 6 - 8 | $490.00
 | Debugging | Multimeter | 1
 | Assemble Intan Board | Intan 32 Channel A2D | 1 | $390.00 | 1 | 2 | $40.00
 |  | 100nF 0402 X5R/X7R 16V Capacitor | 2 | $6.93
 |  | 10nF 0402 X5R/X7R 16V Capacitor | 1 | $5.42
 |  | 8 Pin .050" Micro Low Profile Terminal Strip | 1 | $0.00 |  |  |  | Sampled w/o cost
 | Intan Board Testing | Function Generator | 1 |  | 2 | 4 - 6 | $350.00
 | Debugging | Multimeter | 1
 | Assemble Battery Board | Keystone 2989 7.9mm battery holder | 1 | $7.68 | 1 | 0.5 | $10.00
 |  | 7.9mm Silver Oxide battery | 1 | $13.50
 |  | 1 Pin .050" Micro Low Profile Terminal Strip | 1 | $0.00 |  |  |  | Sampled w/o cost
 | Battery Board Testing | Function Generator | 1 |  | 1 | 0.5 | $17.50
 | Debugging | Multimeter | 1
 | Full Assembly | Previously Assembled Parts | / | $33.00 | 2 | 3 | $120.00 | Includes PCB design, printing and board cost
 | TOTAL |  |  | $ 537.86 |  |  | $1107.50
 |  |  |  |  |  | TOTAL COST | $1645.36
