JulianYG/WNR/documentation/Cycle I Documentation/Instructions/Product Development Worksheet 2015 v2.xlsx

Sheet: Design Context Review
Design Context Review (What do I need to know?)
Priority | Research Topics: Background information on design environment
1 | e.g. What are the conditions (temp, pressure, etc) that exist inside the ISS?
2
3
Priority | Research Topics: Information about customers (users, payers, regulators)
1 | e.g. How are the cost of medical devices reimbursed in a hospital?
2
3
Priority | Research Topics: Applicable regulations or standards
1 | e.g. What safety standards exists for the electronics that might be used in our product?
2
3
Priority | Research Topics: Technologies that might be used in your design
1 | e.g. What are the pros/cons of various wireless data transmission protocols?
2
3
Priority | Research Topics: Competetive products or patents
1 | e.g. What products are considered my primary competitors?
2
3

Sheet: Market Analysis
Market Analysis (Who is my customer?)
 | Potential Market Segments | Estimated Market Size | Reference/Reasoning/assumptions | Competitive Products/Solutions | Willingness to pay | Reference/Reasoning/assumptions | Predicted Market Share | Predicted Financial Opportunity
1 | e.g. College students within the US who suffer sleep deprivation | e.g.1.25M students/year | e.g. There are 20 million college students in the US (DOE Statistics) and we assume that during 1/8 of the academic year (in weeks during midterms and finals) atlease half of students are sleep-deprived. | e.g. Time management strategies, coffee, naps, etc. | Students would be willing to pay 4$ for 2 hours of relief from sleep deprivation. They would use this ~20 times/year | Based on the average price of coffee, which students currently pay | 10% | $10,000,000/year
2
3
4
5

Sheet: Customer Needs
Customer Needs (What does my customer need?)
Number | Need | Priority
User Needs
 | e.g. The phone application reduces patient waiting time in the hospital | 1
Payer Needs
 | e.g. The phone app has a similar cost to competitive apps | 3
Regulatory/Standards Needs
 | e.g. The phone app complies with HIPAA regulations | 2

Sheet: HOQ, FOSS, Specs, Objectives
House of Quality, Specifications, FOSS Goals, Objectives
Project Name: |  | Functional Specifications (Test method description at end of sheet)
 |  | Spec #1 | Spec #2 | Spec #3 | Spec #4 | Spec #5 | Spec #6
Priority | CUSTOMER REQUIREMENTS/NEEDS | Duration of a 0-60mph acceleration
1 | The vehicle must accelerate quickly. | X
2
3
4
5
6
7
8
 | Technical Risk/Complexity | High
 | Competive Values | 4.5 sec |  |  |  |  |  | TOTALS (Should sum to 2000 with Cycle 4/5 objectives)
 | Marginal Value | 4.5 sec
 | Ideal Value | 4.0 sec
 | Final Measured Value (Cycle 5) | 4.0 sec
 | Potential Point Value (Students Enter) | 300 |  |  |  |  |  | 300
 | Graded Point Value (Profs Enter) |  |  |  |  |  |  | 0
 | FOSS Cycle I Goals
 | Idea/ approach to explore [Due 9/25/15] |  | Result of exploration |  |  | Next steps
 | FOSS Cycle II Goals
 | Idea/ approach to explore [Due 10/26/15]
 | Objectives for Cycle 2
 | Related Specifications | Objective |  |  |  | Potential Points (<300) | Graded Points
 | Spec 1, Spec 4 |  |  |  |  | 150
 |  |  |  |  | TOTALS (=1500) | 150
 | Objectives for Cycle 3
 | Related Specifications | Objective |  |  |  | Potential Points | Graded Points
 | Spec 1, Spec 4 |  |  |  |  | 150
 |  |  |  |  | TOTALS (=2000) | 150
 | Addtional Objectives (beyond meeting specifications above) for Cycle 4/5
 | Related Specifications | Objective |  |  |  | Potential Points | Graded Points
 | Spec 1, Spec 4 |  |  |  |  | 150
 |  |  |  |  | TOTALS* | 150
 |  |  |  |  | *When summed with potential points for meeting specs (Line 18) should equal 2000 points
Test Methods
Spec Number | Test Method Description
1
2
3
4
5
6
7
8

Sheet: FMEA
Failure Mode and Effects Analysis (FMEA)
 | Potential Failure Mode | Cause(s) | Effect(s) | Probability of Occurance (Frequent-Improbable) | Severity (Catastrophic-Negligible) | Risk Index | Acceptable? | Mitigation Plan
1 | e.g. Dislodgement of electrode from chest | Poor surface preparation, excessive sweat, hair, cord pulled, patient movement | Poor to no electrical signal, patient no longer monitored | Frequent | Significant | 3 | No | Select stronger, water-resistant adhesive for electrode design
2
3
4
5
6
7
8
9
10
11

Sheet: LBM
Labor, Burden and Materials (LBM) Cost Analysis
 | Burdened Labor Rate: | $33.00 | per hour
 | Process Step | Material | Quantity | Cost at Full Scale | # of people | Duration of Task (hrs) | Cost | Notes
 | e.g. Mounting front bars to base | Front bars | 2 | $75.00 | 2 | 0.5 | $183.00
 |  | Base | 1 | $100.00 |  |  | $100.00
 |  | Adhesive | 1 | $5.00 |  |  | $5.00
 | e.g. Task #2 |  |  |  |  |  | $0.00
 |  |  |  |  |  |  | $0.00
 |  |  |  |  |  |  | $0.00
 |  |  |  |  |  |  | $0.00
 |  |  |  |  |  |  | $0.00
 |  |  |  |  |  |  | $0.00
 |  |  |  |  |  |  | $0.00
 | TOTAL |  |  |  |  |  | $288.00
