JulianYG/WNR/documentation/Cycle 1.5 Documentation/Product Development Worksheet 2015_Cycle2.xlsx

Sheet: Design Context Review
Design Context Review (What do I need to know?)
Priority | Research Topics: Background information on design environment
1 | What are the conditions inside the brain?
2 | What environmental standards must the components comply with?
3 | What are the existing products for the purpose?
Priority | Research Topics: Information about customers (users, payers, regulators)
1 | What are users main concerns about WNR?
2 | What kind of diagnosis efficacy does payers want to achieve with WNR?
3 | What are concerns for regulators that may prevent WNR from being released to the market?
4 | How often is the WNR used per day/per month?
5 | How are medical WNRs procured in hospitals? What would be the general willlingness to purchase?
6 | Aside from diagnosing epilepsy lesions in patients brain, what else might payers be interested in with WNR?
Priority | Research Topics: Applicable regulations or standards
1 | Which safety regulations will be having to comply with?
2 | What are the medical WNR design and use standards?
3 | What are the standard procedures to acquire FDA approval?
Priority | Research Topics: Technologies that might be used in your design
1 | What are the pros/cons of various wireless data transmission protocols?
2 | How do we power the WNR effectively?
3 | How can we minimize the size of the WNR?
Priority | Research Topics: Competetive products or patents
1 | Do we have other human rated wireless recorder compeititors?
2 | Cost of compeititors both wired and wireless?
3 | Can we patent this ?

Sheet: Customer Needs
Customer Needs (What does my customer need?)
Number | Need | Priority
User Needs | The WNR is safe for implant procedure and regular operations | 1
 | The WNR, when combined with other corresponding treatments, has significant effect in improving the brain condition | 2
 | The WNR is comfortable and mobile to wear on for regular daily activities. | 3
 | The WNR allows further application development on its platform | 4
Payer Needs | The WNR accurately samples and transmits patient's brain activity data | 1
 | The WNR is mobile, and small in dimension and convenient to use | 2
 | The WNR allows further application development on its platform | 3
Regulatory/Standards Needs | The WNR complies with medical WNR regulations such as FDA, and data privacy rules such as HIPAA. | 1
 | The WNR complies with wireless transmission regulations such as FCC. | 2
 | The WNR complies with marketing standards such as CE, IC for markets outside USA. | 3

Sheet: Market Analysis
Market Analysis (Who is my customer?)
 | Potential Market Segments | Estimated Market Size | Reference/Reasoning/assumptions | Competitive Products/Solutions | Willingness to pay | Reference/Reasoning/assumptions | Predicted Market Share | Predicted Financial Opportunity per year
1 | Hospitals performing ECoG | $ 426,450,000.00 | Total Market Size = # of Hospitals * 10 machines per hospital * Unit Price of EEG Machine | Currently existing wired solutions | If system is of comparable price or cheaper, willingness to pay should be considerable. A machine ought to be used ~180 times/year | Based on the total number of hospitals, total number of EEG operations, and general willingness for hospital to pay for new equipments | 50%~100% (transition to new technology takes time) | $ 213,225,000.00
2 | Clinics Performing ECoG | $ 153,150,000.00 | Total Market Size = # of Hospitals * 10 machines per hospital * Unit Price of EEG Machine | Currently existing wired solutions | If system is of comparable price or cheaper, willingness to pay should be considerable. A machine ought to be used ~180 times/year | Based on the total number of hospitals, total number of EEG operations, and general willingness for hospital to pay for new equipments | 50%~100% (transition to new technology takes time) | $ 76,575,000.00
3 | Household portable EEG users | Unkown |  |  |  |  |  | Potentially small compared to hospitals and clinics
4 | Research groups that utilize EEG | Unkown |  |  |  |  |  | Potentially small compared to hospitals and clinics
 |  |  |  |  |  |  |  | $ 289,800,000.00
 |  | Number of EEG per practice |  | 1791.197544
 |  |  |  | EEG machines per hospital | Unit Price | Total Investment
 |  | No. of Rural Clinics | 4084 | 5 | 7500 | $ 153,150,000.00
 |  | No. of Hospitals | 5686 | 10 | 7500 | $ 426,450,000.00
 |  |  |  |  | Total | $ 579,600,000.00

Sheet: HOQ, FOSS, Specs, Objectives
House of Quality, Specifications, FOSS Goals, Objectives
Project Name: Rice WNR |  | Functional Specifications (Test method description at end of sheet)
 |  | Spec #1 | Spec #2 | Spec #3 | Spec #4 | Spec #5 | Spec #6 | Spec #7 | Spec #8
Priority | CUSTOMER REQUIREMENTS/NEEDS | Transmission Rate | Sampling Precision | Sampling Rate | Skin Temperature Change | Module Size | Battery Life | Operable Range | DC Offset
1 | Safe |  |  |  | X |  |  |  | X
2 | Real-Time, Accurate, and Reliable | X | X | X |  |  |  |  | X
3 | Portable/Convenient/Low Power |  |  |  |  | X | X | X
 | Technical Risk/Complexity | Medium | Low | Low | Medium | High | Medium | Medium | Medium
 | Competitive Values | 15 Mb/s | 64-channel, 10-bit | 100 kHz | < 2 C / 3.6 F | 5.4 x 4.7 mm | up to 5 years | 4 meters | 1 - 2 V | TOTALS (Should sum to 2000 with Cycle 4/5 objectives)
 | Marginal Value | 128 kb/s/electrode | 16-channel, 8-bit | 1 kHz | < 2 C / 3.6 F | 10 x 10 mm | 6 hours | 2 meters | 0 - 2 V
 | Ideal Value | 256 kb/s/electrode | 16-channel, 16-bit | 1 kHz | < 1 C / 1.8 F | 4 x 4 mm | few years | 4 meters | 0 - 1 V
 | Final Measured Value (Cycle 5)
 | Potential Point Value (Students Enter) |  |  |  |  |  |  |  |  | 0
 | Graded Point Value (Profs Enter) |  |  |  |  |  |  |  |  | 0
 | FOSS Cycle I Goals
 | Idea/ approach to explore [Due 9/25/15] | What was Learned | Next Step
 | Talk to OEDK staff about facilities and acquire training: PCB Mill, 3D printing | We learned about 3D printing and laser cutting by talking with the lab assistants and performed some prototyping. | We have already acquired sufficient knowledge, and we are able to locate resources for further training if needed.
 | Survey competitors: DEUTERON, NEUROPACE, NEURONEXUS, INTAN | None of the listed companies are direct competitors; in fact, Intan will most likely be one of the suppliers for our components. We made email correspondence with the founder of Intan Technologies to learn about the specific specifications of their analog front-end products, which contributed to our feasibility analysis of the project. | Keep on the lookout for more competitors. Past research has shown that our product exists in a niche market where few competitors exist.
 | Talk to neurosurgeons about what they need: Dr. Tandon | We had informative meetings with our sponsor, Dr. Tandon that clearly defined our requirements and specifications. | Talk with more neurosurgeons. Get sample neural ECoG data and discuss the possibility of having a field trip to experience a electrode implantation procedure.
 | Wireless Communication first Prototype | We researched on commercially available BLE chips and purchased several development boards from TI and Nordic Labs. We began development, but it was much more difficult than anticipated. We also consulted TI engineers regarding the feasibility of our scheme and found that our overall scheme may be almost impossible to complete given our budget and time constraints. | Report to sponsor about feasibility analysis and discuss possible alternative designs. Keep working on BLE development. Research on commmunication protocols suggested by TI. Begin development on server side.
 | Analog front-end first prototype | We performed extensive market research on commercially available analog front-end components and have narrowed our choice to the Intan RHD2000 chip. However, due to budget constraints further consultation of sponsor is required before we make a purchase. | Discuss with sponsor, the feasibility (not only in terms of cost but also in terms of difficulty of integration) of using the Intan chip. Purchase the component if we decide to use this chip.
 | Survey ADC chips | We found that most analog front-end components integrates its analog amplifier and ADC into one product. | Discuss with sponsor, the feasibility (not only in terms of cost but also in terms of difficulty of integration) of using the Intan chip. Purchase the component if we decide to use this chip.
 | Survey wireless or BLE chips | We purchased a few components from TI and Nordic Labs that meets the design criteria in terms of form factor and power consumption. This provides a good foundation for prototyping. | Continue development with the purchased products. In case other wireless protocols are required, we will perform further market research for these components.
 | Survey Analog Front-end Neuro-Recording Technology | We read papers and realized that extensive research has been done in the area. There are commercially available products available that far exceeds the capabilities of what we could deliver if we chose to design the analog front-end ourselves. | Past work has led us to conclude that purchasing commercially available analog front-end chips, like those from Intan, is the best choice for our project.
 | Survey wireless protocols: Bandwidth limit | The usuable bandwidth of BLE technology is around 750 kpbs. We estimated our bandwidth usage to be around 1 Mbps without overhead, so we need to find a way to reduce our bandwidth usage by at least 2x. | Research probable methods for decimating and/or compressing data to meet the BLE bandwidth limit.
 | Request fieldtrip: watch a live Intracranial EEG operation | Dr. Tandon mentioned that he could fulfill this request. | Set a time for the field trip and go experience live surgery.
 | FOSS Cycle II Goals
 | Idea/ approach to explore [Due 10/26/15] |  | What was learned |  |  | Next Step
 | Configure the TI CC2650 and Nordic Labs BLE chips to deliver custom messages wirelessly. |  | It is very easy to deliver custom messages between peripheral and central client using the Nordic nRF52. We have setup and demonstrated data transmission involving BLE and UART protocol. However, after looking further into the capabilities of BLE, while programming the peripheral client to transmit continuously to the central client, we realized the limitations of the BLE technology. BLE can only transmit one packet at a time and only during a connection interval. As specified by the protocol, the period between the connection intervals can be at smallest 7.5 ms. With the capacity of the Nordic nRF52 boards, each packet sent contains 20 bytes of data and at most 6 packets from 6 different characteristics or services. This yields a throughput of only 128 kbps, which is four times lower than the minimum sampling rate specification we were given. The 1 Mbps is actually the theoretical symbol rate of BLE. We were able to confirm that in one connection interval, we could send at most 20 bytes of data from the peripheral to central. Anymore data that we tried to send caused the application to hang even after sending more requests at a later time. |  |  | Since we just found out that the actual transmission rate that BLE can provide is much lower than what we initially thought, we have to switch to a higher bandwidth protocol. Bluetooth classic would seem like the next best choice, since it's typical throughput is around 0.7 - 2.1 Mbps. However Bluetooth classic supports at most 7 devices connected in one local network, while our array will potentially have to accommodate up to 16 peripheral devices. The next best option we can use is WiFi, which will support the data transmission rates we require even without compression, and supports up to 255 devices. We will look into WiFi solutions for data transmission moving forward.
 | Select a viable communication protocol for encoding wireless messages. |  | A separate encoding scheme is not necessary because Bluetooth has its own transmission scheme that accounts for error handling |  |  | No further action is required.
 | Research relevant regulations and stipulations for obtaining real ECoG data. |  | We completed CITI training module required to obtain clinical EEG and ECoG data. |  |  | No further action is required until we need to perform animal testings.
 | Measure power consumption after configuring Bluetooth wireless chips to deliver custom messages. This is required to verify our analysis of power consumption. |  | Power consumption seems a little lower when tested than stated in data sheet |  |  | Measure power consumption using an oscilloscope to better characterize the power curve; we may not be measuring correctly or need data over time to better characterize the power consumption of the chip.
 | Confirm and purchase Intan chip with 64 channels, even though only 16 channels will be currently used. |  | We contacted Intan and inquired about the parts. We received feedback and suggestions regarding the specific parts we should purchase and purchases have been made to obtain these components. |  |  | No further action is required.
 | Look into compression algorithms like Adaptive Huffman Encoding and experiment to see how well they compress ECoG data. |  | Compression no longer needed with change to bluetooth classic |  |  | Still look into other algorithms, like ALZ77 because if we can achieve good compression results, we can still switch back to to BLE. Ideally we should use BLE because BLE has a much lower power consumption than Bluetooth classic.
 | Request ECoG data from Dr. Tandon and/or Professor Behnaam Aazhang and understand ECoG data characteristics. |  | Data was requested and is currently under analysis. |  |  | No further action is required unless additional data is needed.
 | Look at different network topologies that BLE supports such as a star vs. point to point. Compare ease of implementation, device limits, and connectivity overhead. |  | BLE only supports star topology. Even if we decide to use a different protocol, a star topology is probably most efficient and convenient topology to use. |  |  | No further action is required as bluetooth class is being used
 | Measure efficiency and power consumption of the Intan Chip. |  | The Intan Chip hardwires the amplifier chip to only use LVDS signaling for its amplifier board. As such, we have purchased LVDS-to-CMOS converter to facilitate programing and analysis of the chip |  |  | Once the converter IC arrives, we will solder it onto a breakout board and start programming the Intan Chip as soon as possible.
 | Build first prototype of server/receiver application; it can be something as crude as a MATLAB script. |  | We used the existing software platform from Nordic and looked at the source code of the application. We also purchased the bluetooth dongle that can be used to provide BLE communication to computers (which only supports classic Bluetooth) |  |  | We will program the bluetooth dongle and also hack the source code for the app.
 | Test error rate of wireless transmission in various environments, like hospital rooms, school, office, etc. |  | Due to unforseen problem with CC2650 evaluation boards (one of the two boards we have seemed to have stopped working), this error rate testing could not be performed as expected. |  |  | We will find alternatives to using the CC2650 board and the error testing code. Using Bluetooth classic CC2564 instead now
 | Objectives for Cycle 2
 | Related Specifications | Objective |  |  |  | Potential Points (<300) | Graded Points
 | Spec 1, Spec 7 | Achieve Bluetooth transmission of custom information from transmitter to receiver using TI Chip. |  |  |  | 300
 | Spec 1, Spec 2, Spec 3 | Wirelessly transmit 1000 samples per second, each with 8-bit precision and evaluate performance (sample loss rate) |  |  |  | 4
 | Spec 2, Spec 3, Spec 8 | Read in 1 ksamples/s from the Intan Chip (AFE) through SPI
 | Spec 6 | Measure power consumption of wireless transmission component, while transmitting at 1000 samples per second and compare to the theoretical calculated values to verify that the system is not only theoretically viable.
 |  |  |  |  | TOTALS (=1500) | 304
 | Objectives for Cycle 3
 | Related Specifications | Objective |  |  |  | Potential Points | Graded Points
 | Spec 1, 7 |  |  |  |  | 150
 |  |  |  |  | TOTALS (=2000) | 150
 | Addtional Objectives (beyond meeting specifications above) for Cycle 4/5
 | Related Specifications | Objective |  |  |  | Potential Points | Graded Points
 | Spec 1, Spec 4 |  |  |  |  | 150
 |  |  |  |  | TOTALS* | 150
 |  |  |  |  | *When summed with potential points for meeting specs (Line 18) should equal 2000 points
Test Methods
Spec Number | Test Method Description
1 | While product is running, see if data is being sent in real time to the receiver; observe the number of bytes received by the receiver per unit of time.
2 | Observe that the values being recorded from the electrode meets the specification.
3 | Compare the waveform collected from the product to the waveform of a WNR that is known to sample at 1 kHz.
4 | Measure skin temperature before WNR is running. Measure skin temperature after WNR has been running after awhile.
5 | Measure dimensions of WNR after building it.
6 | Observe current draw as WNR is running. From this, we can determine the battery life based on battery specifications.
7
8

Sheet: FOSS I Goals
FOSS Cycle I Goals
Idea/ approach to explore [Due 9/25/15] | What was Learned | Next Step
Talk to OEDK staff about facilities and acquire training: PCB Mill, 3D printing | We learned about 3D printing and laser cutting by talking with the lab assistants and performed some prototyping. | We have already acquired sufficient knowledge, and we are able to locate resources for further training if needed.
Survey competitors: DEUTERON, NEUROPACE, NEURONEXUS, INTAN | None of the listed companies are direct competitors; in fact, Intan will most likely be one of the suppliers for our components. We made email correspondence with the founder of Intan Technologies to learn about the specific specifications of their analog front-end products, which contributed to our feasibility analysis of the project. | Keep on the lookout for more competitors. Past research has shown that our product exists in a niche market where few competitors exist.
Talk to neurosurgeons about what they need: Dr. Tandon | We had informative meetings with our sponsor, Dr. Tandon that clearly defined our requirements and specifications. | Talk with more neurosurgeons. Get sample neural ECoG data and discuss the possibility of having a field trip to experience a electrode implantation procedure.
Wireless Communication first Prototype | We researched on commercially available BLE chips and purchased several development boards from TI and Nordic Labs. We began development, but it was much more difficult than anticipated. We also consulted TI engineers regarding the feasibility of our scheme and found that our overall scheme may be almost impossible to complete given our budget and time constraints. | Report to sponsor about feasibility analysis and discuss possible alternative designs. Keep working on BLE development. Research on commmunication protocols suggested by TI. Begin development on server side.
Analog front-end first prototype | We performed extensive market research on commercially available analog front-end components and have narrowed our choice to the Intan RHD2000 chip. However, due to budget constraints further consultation of sponsor is required before we make a purchase. | Discuss with sponsor, the feasibility (not only in terms of cost but also in terms of difficulty of integration) of using the Intan chip. Purchase the component if we decide to use this chip.
Survey ADC chips | We found that most analog front-end components integrates its analog amplifier and ADC into one product. | Discuss with sponsor, the feasibility (not only in terms of cost but also in terms of difficulty of integration) of using the Intan chip. Purchase the component if we decide to use this chip.
Survey wireless or BLE chips | We purchased a few components from TI and Nordic Labs that meets the design criteria in terms of form factor and power consumption. This provides a good foundation for prototyping. | Continue development with the purchased products. In case other wireless protocols are required, we will perform further market research for these components.
Survey Analog Front-end Neuro-Recording Technology | We read papers and realized that extensive research has been done in the area. There are commercially available products available that far exceeds the capabilities of what we could deliver if we chose to design the analog front-end ourselves. | Past work has led us to conclude that purchasing commercially available analog front-end chips, like those from Intan, is the best choice for our project.
Survey wireless protocols: Bandwidth limit | The usuable bandwidth of BLE technology is around 750 kpbs. We estimated our bandwidth usage to be around 1 Mbps without overhead, so we need to find a way to reduce our bandwidth usage by at least 2x. | Research probable methods for decimating and/or compressing data to meet the BLE bandwidth limit.
Request fieldtrip: watch a live Intracranial EEG operation | Dr. Tandon mentioned that he could fulfill this request. | Set a time for the field trip and go experience live surgery.

Sheet: FMEA
Failure Mode and Effects Analysis (FMEA)
 | Potential Failure Mode | Cause(s) | Effect(s) | Probability of Occurance (Frequent-Improbable) | Severity (Catastrophic-Negligible) | Risk Index | Acceptable? | Mitigation Plan
1 | Dislodgement of electrode from head | Poor surface preparation, excessive sweat, hair, cord pulled, patient movement | Poor to no electrical signal, patient no longer monitored, damage to brain | Frequent | Significant | 3 | No | Select stronger, water-resistant adhesive for electrode design, fixing screw or cap onto scalp, small form factor
2 | Overheating | Turn on too long, high power consumption | WNR stops working, damage or burn skin of patient | Improbable | Significant | 15 | No | small form factor, reduce power consumption and current draw
3 | Electric Surge | Turn on too long, poor circuit design | Damage or shock to patient | Improbable | Significant | 15 | No | Blocking mechanism preventing backward current flow
4 | Contact with Water | Sweating, Rain | Damage circuitry, potential power leakage | Improbable | Significant | 15 | No | Maintain good clinical environment
5 | Electrode gets removed from cap inside head | Forceful impact on the electrodes | Dislodgment of electrode, movement of electrode inside the brain | Occasional | Significant | 6 | No | Select stronger electrodes, fixing screw or cap onto scalp, small form factor
6 | Data confidentiality compromise | Malicious eavesdropping | Loss of confidential patient data, skew data | Improbable | Significant | 15 | No | Closed-loop system with shielded components
7 | Erosion of electrode inside brain | Leave electrode in brain for extended periods of time | Loss of data, harm to surrounding brain tissue | Occasional | Significant | 6 | No | Choose stronger and anti-corrosive materials for the electrodes
8 | Electromagnetic Pulse | Electrode acts as antenna and transfers large pulses into current surges | Damage to WNR, harm to patient | Highly improbable | Marginal | 17 | Yes | Optional shield or helmet to block out large pulses

Sheet: FOSS II Goals
FOSS Cycle II Goals
Idea/ approach to explore [Due 10/26/15] | What was learned | Next Step
Configure the TI CC2650 and Nordic Labs BLE chips to deliver custom messages wirelessly. | It is very easy to deliver custom messages between peripheral and central client using the Nordic nRF52. We have setup and demonstrated data transmission involving BLE and UART protocol. However, after looking further into the capabilities of BLE, while programming the peripheral client to transmit continuously to the central client, we realized the limitations of the BLE technology. BLE can only transmit one packet at a time and only during a connection interval. As specified by the protocol, the period between the connection intervals can be at smallest 7.5 ms. With the capacity of the Nordic nRF52 boards, each packet sent contains 20 bytes of data and at most 6 packets from 6 different characteristics or services. This yields a throughput of only 128 kbps, which is four times lower than the minimum sampling rate specification we were given. The 1 Mbps is actually the theoretical symbol rate of BLE. We were able to confirm that in one connection interval, we could send at most 20 bytes of data from the peripheral to central. Anymore data that we tried to send caused the application to hang even after sending more requests at a later time. | Since we just found out that the actual transmission rate that BLE can provide is much lower than what we initially thought, we have to switch to a higher bandwidth protocol. Bluetooth classic would seem like the next best choice, since it's typical throughput is around 0.7 - 2.1 Mbps. However Bluetooth classic supports at most 7 devices connected in one local network, while our array will potentially have to accommodate up to 16 peripheral devices. The next best option we can use is WiFi, which will support the data transmission rates we require even without compression, and supports up to 255 devices. We will look into WiFi solutions for data transmission moving forward.
Select a viable communication protocol for encoding wireless messages. | A separate encoding scheme is not necessary because Bluetooth has its own transmission scheme that accounts for error handling | No further action is required.
Research relevant regulations and stipulations for obtaining real ECoG data. | We completed CITI training module required to obtain clinical EEG and ECoG data. | No further action is required until we need to perform animal testings.
Measure power consumption after configuring Bluetooth wireless chips to deliver custom messages. This is required to verify our analysis of power consumption. | Power consumption seems a little lower when tested than stated in data sheet | Measure power consumption using an oscilloscope to better characterize the power curve; we may not be measuring correctly or need data over time to better characterize the power consumption of the chip.
Confirm and purchase Intan chip with 64 channels, even though only 16 channels will be currently used. | We contacted Intan and inquired about the parts. We received feedback and suggestions regarding the specific parts we should purchase and purchases have been made to obtain these components. | No further action is required.
Look into compression algorithms like Adaptive Huffman Encoding and experiment to see how well they compress ECoG data. | Compression no longer needed with change to bluetooth classic | Still look into other algorithms, like ALZ77 because if we can achieve good compression results, we can still switch back to to BLE. Ideally we should use BLE because BLE has a much lower power consumption than Bluetooth classic.
Request ECoG data from Dr. Tandon and/or Professor Behnaam Aazhang and understand ECoG data characteristics. | Data was requested and is currently under analysis. | No further action is required unless additional data is needed.
Look at different network topologies that BLE supports such as a star vs. point to point. Compare ease of implementation, device limits, and connectivity overhead. | BLE only supports star topology. Even if we decide to use a different protocol, a star topology is probably most efficient and convenient topology to use. | No further action is required as bluetooth class is being used
Measure efficiency and power consumption of the Intan Chip. | The Intan Chip hardwires the amplifier chip to only use LVDS signaling for its amplifier board. As such, we have purchased LVDS-to-CMOS converter to facilitate programing and analysis of the chip | Once the converter IC arrives, we will solder it onto a breakout board and start programming the Intan Chip as soon as possible.
Build first prototype of server/receiver application; it can be something as crude as a MATLAB script. | We used the existing software platform from Nordic and looked at the source code of the application. We also purchased the bluetooth dongle that can be used to provide BLE communication to computers (which only supports classic Bluetooth) | We will program the bluetooth dongle and also hack the source code for the app.
Test error rate of wireless transmission in various environments, like hospital rooms, school, office, etc. | Due to unforseen problem with CC2650 evaluation boards (one of the two boards we have seemed to have stopped working), this error rate testing could not be performed as expected. | We will find alternatives to using the CC2650 board and the error testing code. Using Bluetooth classic CC2564 instead now

Sheet: High Priority Specs
Team: WNR
Stephen Xia
Tingkai Liu
Yuan Gao
Xin Huang
Cycle II: High Priority Specifications
 |  | Spec #1 | Spec #2 | Spec #3 | Spec #4 | Spec #5 | Spec #6 | Spec #7 | Spec #8
Priority | CUSTOMER REQUIREMENTS/NEEDS | Transmission Rate | Sampling Precision | Sampling Rate | Skin Temperature Change | Module Size | Battery Life | Operable Range | DC Offset
1 | Safe |  |  |  | X |  |  |  | X
2 | Real-Time, Accurate, and Reliable | X | X | X |  |  |  |  | X
3 | Portable/Convenient/Low Power |  |  |  |  | X | X | X
 | Technical Risk/Complexity | Medium | Low | Low | Medium | High | Medium | Medium | Medium
 | Competitive Values | 15 Mb/s | 64-channel, 10-bit | 100 kHz | < 2 C / 3.6 F | 5.4 x 4.7 mm | up to 5 years | 4 meters | 1 - 2 V | TOTALS (Should sum to 2000 with Cycle 4/5 objectives)
 | Marginal Value | 128 kb/s/electrode | 16-channel, 8-bit | 1 kHz | < 2 C / 3.6 F | 10 x 10 mm | 6 hours | 2 meters | 0 - 2 V
 | Ideal Value | 256 kb/s/electrode | 16-channel, 16-bit | 1 kHz | < 1 C / 1.8 F | 4 x 4 mm | few years | 4 meters | 0 - 1 V
 | Final Measured Value (Cycle 5)
 | Potential Point Value (Students Enter) |  |  |  |  |  |  |  |  | 0
 | Graded Point Value (Profs Enter) |  |  |  |  |  |  |  |  | 0
Objectives for Cycle 2
Related Specifications | Objective |  |  |  | Potential Points (<300) | Graded Points
Spec 1, 2, 3, 6 | 1. Wireless Transmission
 | 1.1. Achieve wireless transmission of custom information from a custom chip to a receiver. |  |  |  | 200
 | 1.2. Wirelessly and continuously transmit 1000 samples/s/channel for at least 16 channels (16,000 samples/s total) and evaluate performance (sample loss rate of wireless transmission rate) |  |  |  | 200
 | 1.3. Continuously transmit data from at least two wireless chips (peripherals) to a receiver at the same time. |  |  |  | 100
 | 1.4. Measure power consumption of wireless transmission component, while transmitting at 1000 samples/s/channel for at least 16 channels (16,000 samples/s total) and compare to the theoretically calculated values to verify viability of system. |  |  |  | 150
Spec 2, Spec 3, Spec 6 | 2. Analog Front-End
 | 2.1. Interface LVDS converter with Intan Chip to convert Intan Chip output to normal SPI. |  |  |  | 200
 | 2.2. Read in and display 1 ksamples/s/channel for at least 16 channels from the Intan Chip through SPI |  |  |  | 200
 | 2.3. Measure power consumption of the Intan Chip (AFE) while sampling and reading 1 ksamples/s/channel for at least 16 channels using SPI and compare to the theoretically calculated values to verify viability of system. |  |  |  | 150
Spec 1 | 3. Compression and Data Analysis
 | 3.1. Obtain live IEEG data with proper permissions to view and analyze the data |  |  |  | 100
 | 3.2. Apply Huffman Encoding and measure compression rate on live data |  |  |  | 200
 |  |  |  | TOTALS (=1500) | 1500

Sheet: Related Specs
Related Specifications | Objective | Potential Points (<300)
Spec 1, 2, 3, 6 | 1. Wireless Transmission
 | 1.1. Achieve wireless transmission of custom information from a custom chip to a receiver. | 200
 | 1.2. Wirelessly and continuously transmit 1000 samples/s/channel for at least 16 channels (16,000 samples/s total) and evaluate performance (sample loss rate of wireless transmission rate) | 200
 | 1.3. Continuously transmit data from at least two wireless chips (peripherals) to a receiver at the same time. | 100
 | 1.4. Measure power consumption of wireless transmission component, while transmitting at 1000 samples/s/channel for at least 16 channels (16,000 samples/s total) and compare to the theoretically calculated values to verify viability of system. | 150

Sheet: LBM
Labor, Burden and Materials (LBM) Cost Analysis
 | Burdened Labor Rate: | $33.00 | per hour
 | Process Step | Material | Quantity | Cost at Full Scale | # of people | Duration of Task (hrs) | Cost | Notes
 | e.g. Mounting front bars to base | Front bars | 2 | $75.00 | 2 | 0.5 | $ 183.00
 |  | Base | 1 | $100.00 |  |  | $ 100.00
 |  | Adhesive | 1 | $5.00 |  |  | $ 5.00
 | e.g. Task #2 |  |  |  |  |  | $ -
 |  |  |  |  |  |  | $ -
 |  |  |  |  |  |  | $ -
 |  |  |  |  |  |  | $ -
 |  |  |  |  |  |  | $ -
 |  |  |  |  |  |  | $ -
 |  |  |  |  |  |  | $ -
 | TOTAL |  |  |  |  |  | $ 288.00
