JulianYG/WNR/documentation/Cycle I Documentation/FOSS I Evaluations.pptx

## WNR FOSS I Evaluation

## Talk to OEDK staff about facilities and acquire training: PCB Mill, 3D printing

- 3D printing, laser-cutting, and prototyping
- Next Steps: We have sufficient knowledge of the equipment relevant to our project in OEDK, and can obtain any further training when necessary.

## 2. Survey competitors: DEUTERON, NEUROPACE, NEURONEXUS, INTAN

- None of the listed companies are direct competitors
- Made email correspondence with the founder of Intan to learn more about the system
  - Most likely be suppliers of our analog front-end, since their RHD series does everything we require
- Next Steps: Keep on the lookout for more competitors. Past research addresses the issue of digitizing neural data.

## Talk to neurosurgeons, like Dr. Tandon, about what they need

- Clearly laid out the specifications he would like us to achieve.
  - array of 16 electrodes with 16 channels each.
  - battery life of 24 hours at least
  - must fit in a 8 x 8 x 10 mm box maximum
- Next Steps:
  - Speak with more neurosurgeons
  - Get sample ECoG data for testing
  - Schedule a field trip to experience a live device implantation surgery

## 4. Wireless Communication first Prototype

- Researched available TI and Nordic Labs chips
- Began development, but was much more difficult than anticipated
- Consulted TI engineers and other staff engineers about the wireless transmission protocol and feasibility of our system
  - Very difficult, if not impossible to achieve given our time and budget constraints
  - Suggested a point-to-point star topology communication network
- Next Steps:
  - Keep discussing alternative designs
  - Keep trying to develop in the BLE stack
  - Research and attempt methods suggested by professional engineers

## 5. Analog front-end first prototype

- Performed market research on commercially available products
- Found that the Intan RHD series meets our specified requirements.
  - If we can successfully use this chip, we do not have to create our own front-end
- Next Steps: Confirm feasibility with sponsors and mentors and make purchase

## 6. Survey ADC chips

- Most analog front-end and/or microcontroller chips come with ADC
- Next Steps: Focus on confirming the feasibility of the Intan chip

## 7. Survey wireless or BLE chips

- Found a few BLE chips from TI (CC2650) and Nordic Labs, which serves as a starting point for prototyping
- Next Steps: Continue prototyping with current products. If other wireless protocols are later determined to be required, survey more chips

## 8. Survey Analog Front-end Neuro-Recording Technology

- Read papers and realized that there has been a lot of previous research in this area
- There are commercially available products that can provide us with a better analog front-end than what we can develop
- Next Steps: Confirm the feasibility and purchase the Intan chip for analog front-end

## 9. Survey wireless protocols: Bandwidth limit

- The usable bandwidth of BLE technology is around 750 kb/s
- We estimate that we require around 1 Mb/s bandwidth.
- Next Steps: Find more compression and decimation methods to reduce our required data rate to be below 750 kb/s.

## 10. Request fieldtrip: watch a live Intracranial EEG operation

- Dr. Tandon agreed to let us observe a live intracranial EEG operation
- Next Steps: Schedule and attend the operation

## Power Feasibility: AFE - Intan RHD2000

1. Amplifier:
  a. Baseline = 200 uA
  b. 7.6 uA/kHz upper cutoff frequency/channel
2. ADC:
  a. Baseline = 510 uA
  b. 2.14 uA/kHz/channel
3. Supply Voltage and Auxiliary Inputs:
  a. 40 uA

## Power Feasibility: AFE - Intan RHD2000

1. Amplifier Current:
  a. 200 uA + 16 * 1* 7.6 uA/Khz/channel = 321.6 uA
2. ADC Current:
  a. 510 uA + 16 * 1 * 2.14 uA/kHz/channel = 544.24 uA
3. Supply Voltage and Auxiliary Inputs:
  a. 40 uA
4. Total Power Consumption with 3.3V Supply
  a. 3.3 * (321.6 + 544.24 + 40) * (10^(-6)) = 2.99 mW
  b. To run for 24 hours: (321.6 + 544.24 + 40) uA * 24 hours = 21.74 mAh

## Power Feasibility: BLE Transmission - TI CC2650

1. Transmit at +0 dBm:
  a. 6.1 mA
  b. Power Consumption with 3.3 V power supply: 3.3V * 6.1 mA * (10 ^ -3) = 20.13 mW
  c. To run for 24 hours: 6.1 mA * 24 hours = 146.4 mAh
2. Transmit at +5 dBm:
  a. 9.1 mA
  b. Power Consumption with 3.3V power supply: 3.3V * 9.1 mA * (10^-3) = 30.03 mW
  c. To run for 24 hours: 9.1 mA * 24 hours = 218.4 mAh

## Power Feasibility: Battery

1. Zinc Air p13:
  a. diameter: 7.9 mm
  b. height: 5.4 mm
  c. Typical capacity 300 mAh

## Power Feasibility: Total System

1. AFE: 21.74 mAh
2. Transmitting at +0 dBm: 146.4 mAh
  a. Total Power Consumption = 21.74 + 146.4 = 168.14 mAh
3. Transmitting at +5 dBm: 218.4 mAh
  a. Total Power Consumption = 21.74 + 218.4 = 240.14 mAh
Using the Zinc-Air p13 battery (300 mAh) is enough to power both types of transmission with enough power for compression and other processing
