JulianYG/WNR/documentation/Cycle III Documentation/Power Measurements.docx

BLE:

- Advertising: 0.90 mA
- Transmitting at 128 kbps:
  - 40 uS ramp up: 6.85 mA
  - Steady-state: 6.0 mA
