JulianYG/WNR/documentation/Cycle II Documentation/Preliminary Testing Plan.xlsx

Test Methods
 |  | Spec #1 | Spec #2 | Spec #3 | Spec #4 | Spec #5 | Spec #6 | Spec #7 | Spec #8
Priority | CUSTOMER REQUIREMENTS/NEEDS | Transmission Rate | Sampling Precision | Sampling Rate | Skin Temperature Change | Module Size | Battery Life | Operable Range | DC Offset
1 | Safe |  |  |  | X |  |  |  | X
2 | Real-Time, Accurate, and Reliable | X | X | X |  |  |  |  | X
3 | Portable/Convenient/Low Power |  |  |  |  | X | X | X
 | Technical Risk/Complexity | Medium | Low | Low | Medium | High | Medium | Medium | Medium
 | Competitive Values | 15 Mb/s | 64-channel, 10-bit | 100 kHz | < 2 C / 3.6 F | 5.4 x 4.7 mm | 1 day | 4 meters | 1 - 2 V | TOTALS (Should sum to 2000 with Cycle 4/5 objectives)
 | Marginal Value | 128 kb/s/electrode | 16-channel, 8-bit | 1 kHz | < 2 C / 3.6 F | 10 x 10 mm | 12 hours | 2 meters | 0 - 2 V
 | Ideal Value | 256 kb/s/electrode | 16-channel, 16-bit | 1 kHz | < 1 C / 1.8 F | 4 x 4 mm | 3 days | 4 meters | 0 - 1 V
 | Final Measured Value (Cycle 5)
 | Potential Point Value (Students Enter) |  |  |  |  |  |  |  |  | 0
 | Graded Point Value (Profs Enter) |  |  |  |  |  |  |  |  | 0
Spec Number | Test Method Description
1 | While product is running, see if data is being sent in real time to the receiver; observe the number of bytes received by the receiver per unit of time.
2 | Observe that the values being recorded from the electrode meets the minimum specifications.
3 | Compare the waveform collected from the product to the waveform of a WNR that is known to sample at 1 kHz.
4 | Place device so that it is in contact with the skin. Measure skin temperature before the device is running. Measure skin temperature after the device has been running after awhile. Take the difference to find the change in temperature.
5 | Measure dimensions of a single wireless control unit after building it.
6 | Observe current draw as the full device is running. From this, we can determine the battery life based on battery specifications.
7 | The device should be able to send valid data stream to server within range of 4 meters. Measure data packet loss. The packet loss rate should not be too high.
8 | When the device is operating, the feedback votage from the probe into the brain should not exceed 0.5V. Use oscilloscope to measure voltage change on probes.
