JulianYG/WNR/documentation/Cycle V Documentaiton/Integrated Power Consumption Measurement.xlsx

Sampling Frequency/Hz | R/Ohm | V/mV | V_idle/mV | V_net/mv | I/mA
1 | 4.7 | 97 | 12 | 85 | 18.08510638
10 | 4.7 | 97 | 12 | 85 | 18.08510638
49.64 | 4.7 | 97 | 12 | 85 | 18.08510638
99.2 | 4.7 | 98 | 12 | 86 | 18.29787234
330.8 | 4.7 | 98.9 | 12 | 86.9 | 18.4893617
496 | 4.7 | 100 | 12 | 88 | 18.72340426
1000 | 4.7 | 101.5 | 12 | 89.5 | 19.04255319
@ 1000Hz, 2 channels | nrf52+LVDS+Intan = 19mA
 | nrf52+LVDS = 8.3mA
 | nrf52 = 2.5-3mA
 | INTAN = 10.7mA
 | nrf52 = 2.5-3mA
 | LVDS = 5.3-5.8mA
