JulianYG/WNR/heatshrink-master/test64_param.jpg

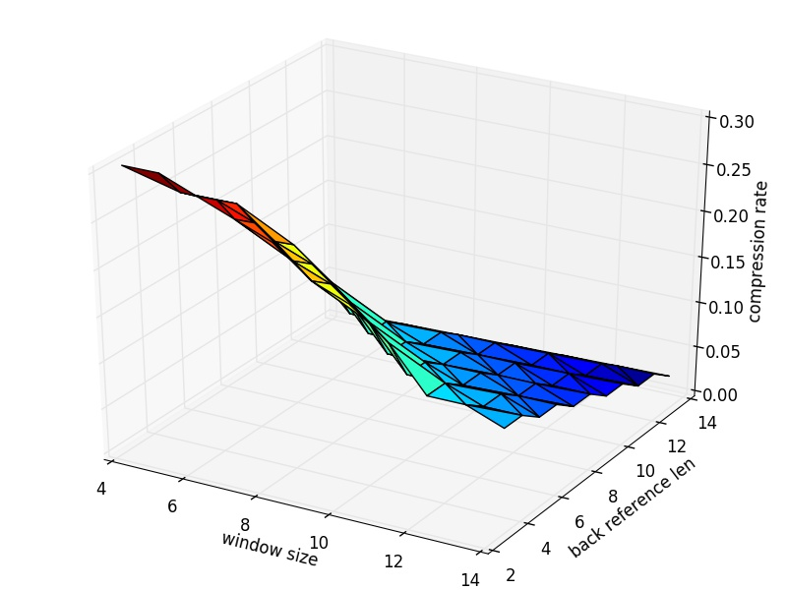
heatshrink-master/test64_param.jpg
