JulianYG/WNR/heatshrink-master/test128_param.jpg

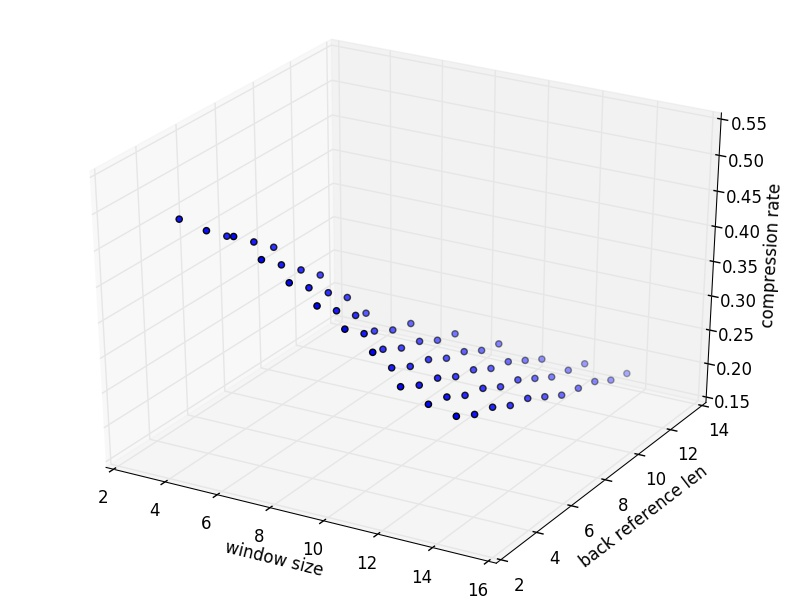
heatshrink-master/test128_param.jpg
