JulianYG/WNR/heatshrink-master/test256_param.jpg

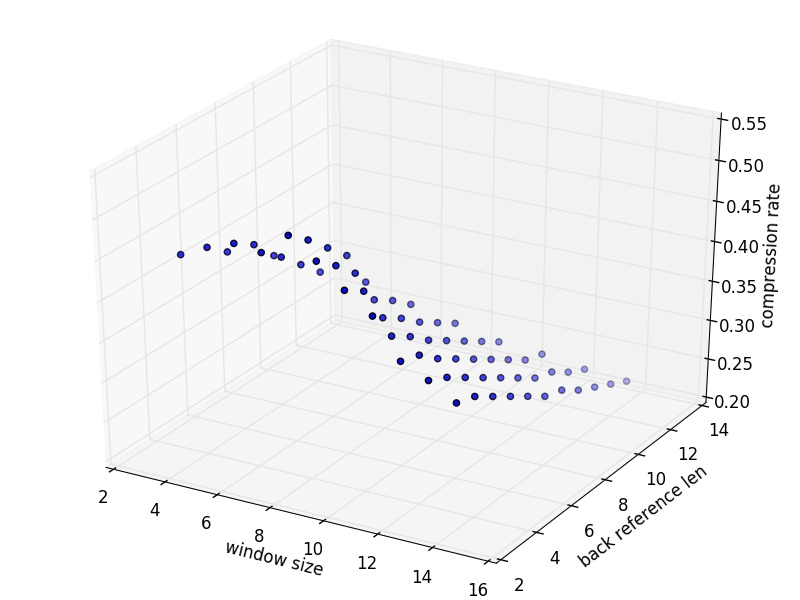
heatshrink-master/test256_param.jpg
