JulianYG/WNR/heatshrink-master/test512_surf_param.jpg

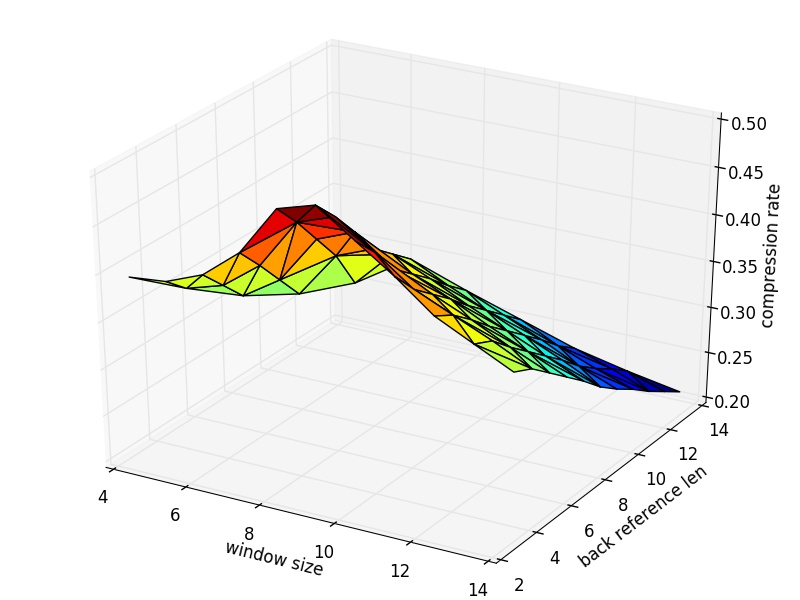
heatshrink-master/test512_surf_param.jpg
