JulianYG/WNR/heatshrink-master/test1024_param.jpg

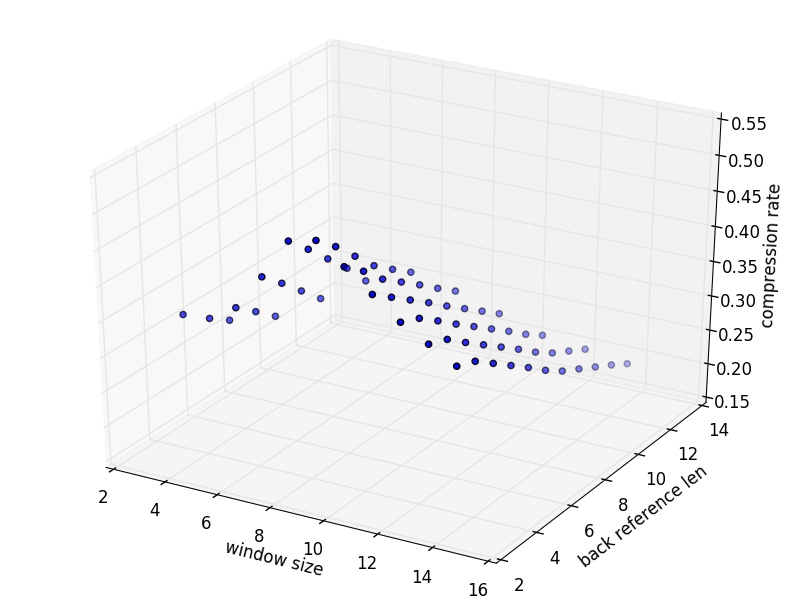
heatshrink-master/test1024_param.jpg
