JulianYG/WNR/heatshrink-master/test2048_param.jpg

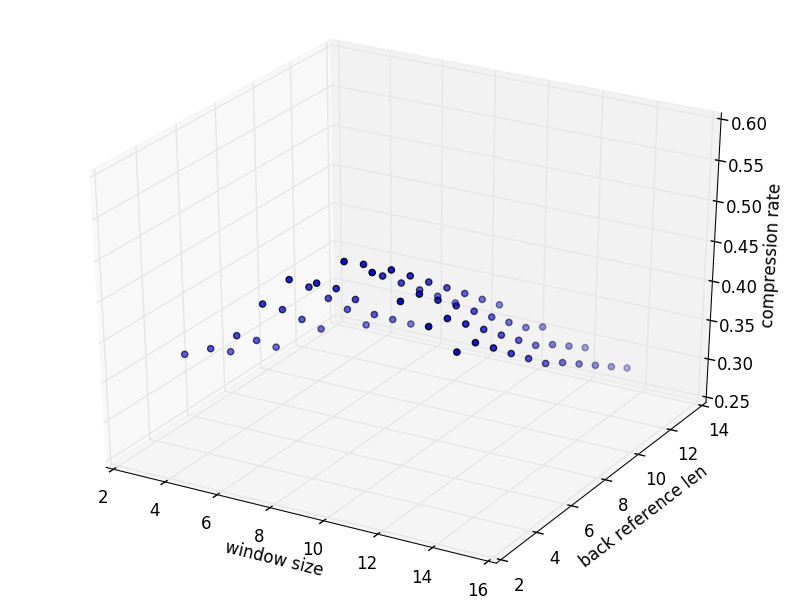
heatshrink-master/test2048_param.jpg
