JulianYG/WNR/heatshrink-master/test2048_surf_param.jpg

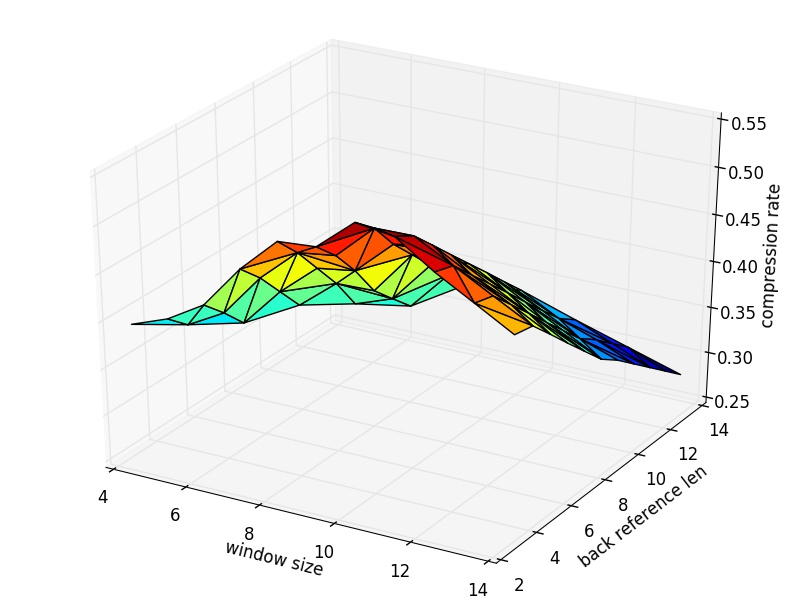
heatshrink-master/test2048_surf_param.jpg
