JulianYG/WNR/heatshrink-master/test4096_param.jpg

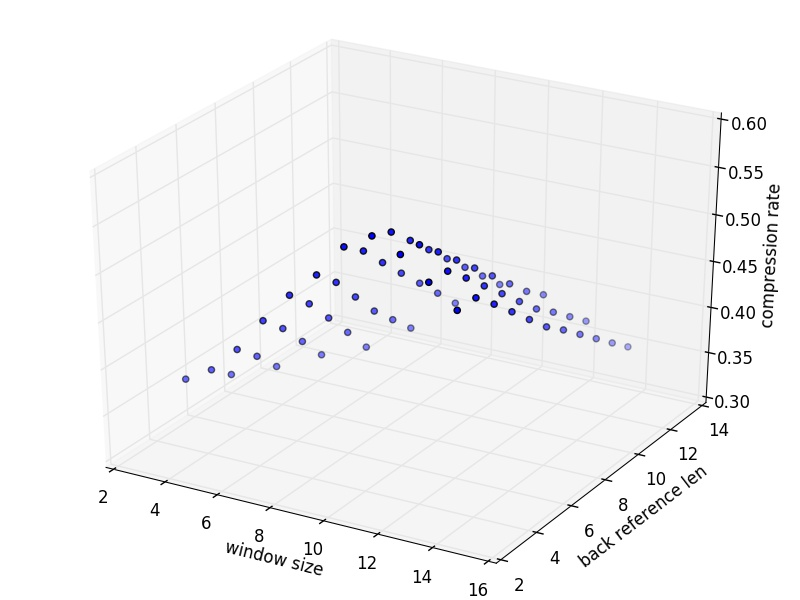
heatshrink-master/test4096_param.jpg
