JulianYG/WNR/heatshrink-master/test4096_surf_param.jpg

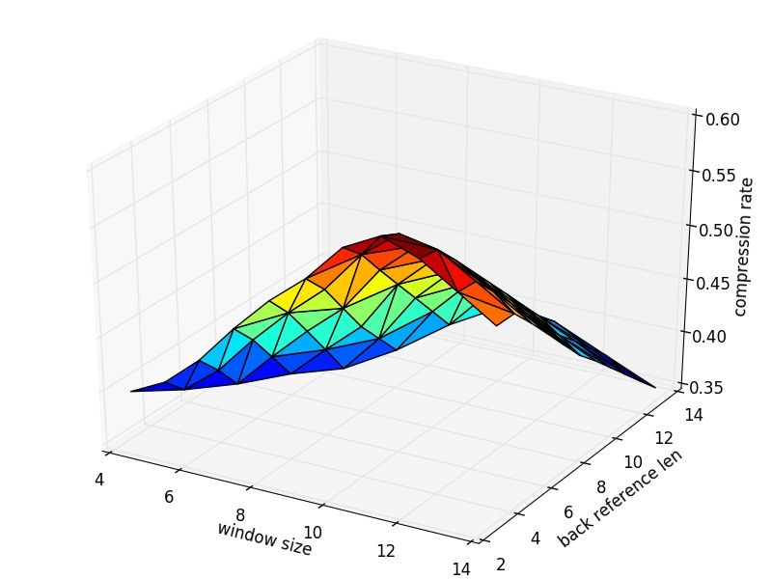
heatshrink-master/test4096_surf_param.jpg
