JulianYG/WNR/heatshrink-master/test8192_param.jpg

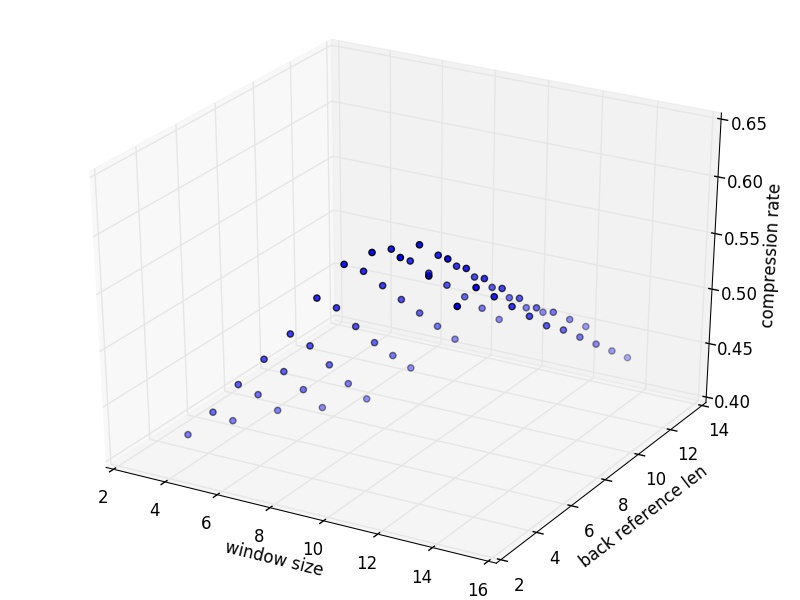
heatshrink-master/test8192_param.jpg
