JulianYG/WNR/heatshrink-master/test8192_surf_param.jpg

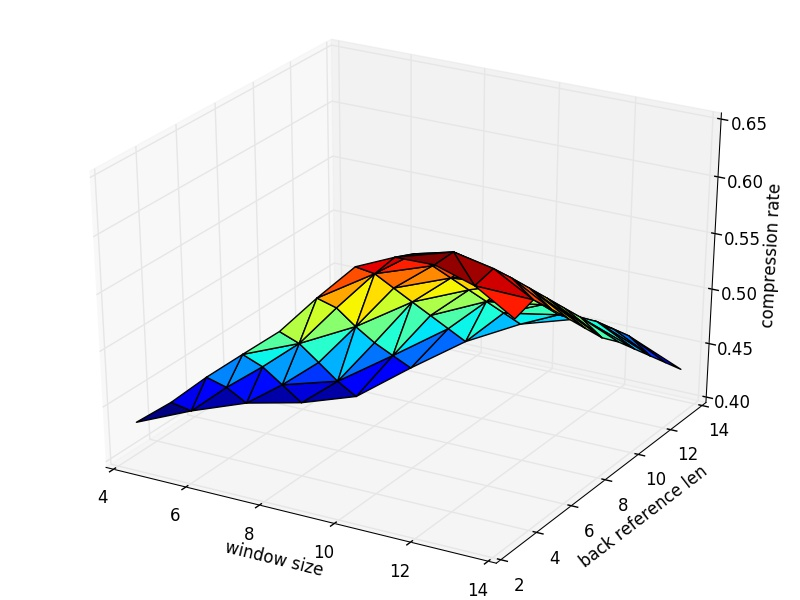
heatshrink-master/test8192_surf_param.jpg
