JulianYG/WNR/documentation/Cycle III Documentation/E_ProductSafetyAnalysis(FMEA)_WNR_Cycle3.xlsx

Failure Mode and Effects Analysis (FMEA)
 | Potential Failure Mode | Cause(s) | Effect(s) | Probability of Occurance (Frequent-Improbable) | Severity (Catastrophic-Negligible) | Risk Index | Acceptable? | Mitigation Plan
1 | Dislodgement of WNR cap device from head | Poor installation, patient or third party tampering | Poor to no electrical and data signal, patient no longer monitored, damage to brain | Improbable | Significant | 3 | No | Select stronger, water-resistant adhesive for installation, Extensive training and instructional information, Small form factor to minimize unintended contact
2 | WNR device Overheating | Running for extended period of time without adequete cooling, abnormaly high current consumption | WNR stops working, damage or burn skin of patient | Improbable | Significant | 8 | No | Small form factor with insulating material at the base and conducting material at the top, reduce power consumption and current draw
3 | Electric Surge | Poor circuit design from missing safety components | Shock to patient or overheating damage to device and patient | Improbable | Significant | 5 | No | Blocking circuit involving diodes to prevent backward current flow. Shieldeld device form factor
4 | Water Penetration | Sweating, Rain, showering, submersion | Damage circuitry, potential power leakage | Improbable | Significant | 7 | No | Maintain good clinical environment and waterproofing design
5 | Electrode gets disconnected from WNR cap inside head | Forceful impact on the electrodes, tampering | Dislodgment of electrode, movement of electrode inside the brain | Improbable | Significant | 6 | No | Select stronger electrodes, fixing screw or cap onto scalp, small form factor
6 | Data confidentiality compromise | Malicious eavesdropping | Loss of confidential patient data, skew data | Improbable | Significant | 13 | No | Secured communication system with validated US components
7 | Erosion of electrode inside brain | Electrode left in brain for extended periods of time | Loss of data, harm to surrounding brain tissue | Highly improbable | Significant | 10 | No | Choose a certified and reputable supplier that uses a stronger and anti-corrosive materials for the electrodes
8 | Electromagnetic Pulse | Electrode acts as antenna and transfers large pulses into current surges | Damage to WNR, incorrect data readings | Highly improbable | Marginal | 15 | Yes | Device will be shielded where possible to allow to wireless communication or helmet to block out large pulses
