JulianYG/WNR/documentation/PCB/Intan_32.brd

## EAGLE design documentation/PCB/Intan_32.brd (2016-05-17)

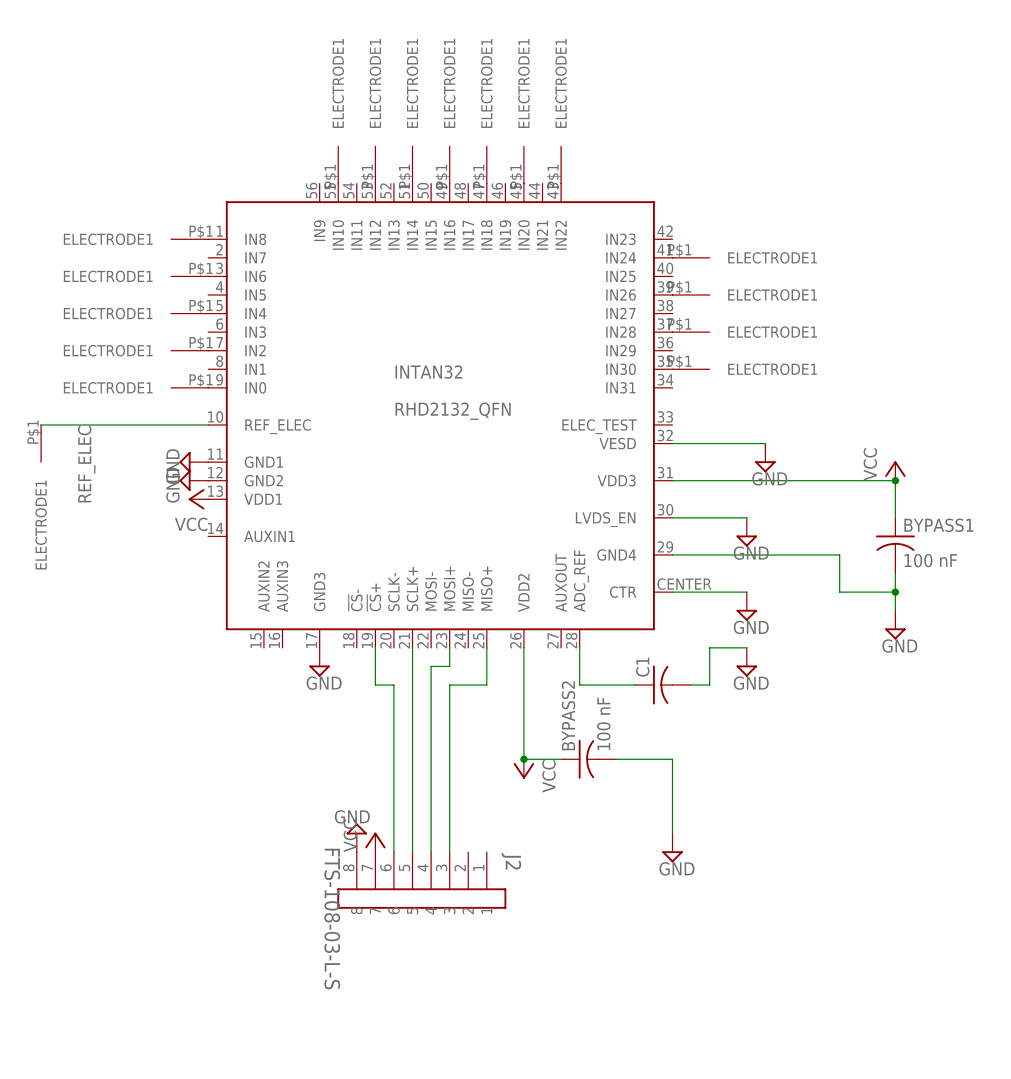
[picture p78: schematic Intan_32.sch]

Parts:
BYPASS1, BYPASS2: 100 nF; C0402
C1: C-USC0402; C0402
INTAN32: RHD2132_QFN; QFN56_8_X_8_LARGE
J2: FTS-108-03-L-S; SAMTEC_FTS-108-03-S
REF_ELEC: INTAN_ELECTRODE_HOLE_2323MIL; INTAN_ELECTRODE_HOLE_23
U$1, U$2, U$3, U$4, U$5, U$6, U$7, U$8, U$9, U$10, U$11, U$12, U$13, U$14, U$15, U$16: INTAN_ELECTRODE_HOLE_2323MIL; INTAN_ELECTRODE_HOLE_23

Connections:
GND: BYPASS1.2, BYPASS2.2, C1.2, INTAN32.11 (GND1), INTAN32.12 (GND2), INTAN32.17 (GND3), INTAN32.29 (GND4), INTAN32.30 (LVDS_EN), INTAN32.32 (VESD), INTAN32.CENTER (CTR), J2.8
unnamed: INTAN32.25 (MISO+), J2.3
unnamed: C1.1, INTAN32.28 (ADC_REF)
unnamed: INTAN32.9 (IN0), U$1.P$1
unnamed: INTAN32.7 (IN2), U$2.P$1
unnamed: INTAN32.23 (MOSI+), J2.4
unnamed: INTAN32.5 (IN4), U$3.P$1
unnamed: INTAN32.3 (IN6), U$4.P$1
unnamed: INTAN32.1 (IN8), U$5.P$1
unnamed: INTAN32.55 (IN10), U$6.P$1
unnamed: INTAN32.19 (!CS!+), J2.6
unnamed: INTAN32.21 (SCLK+), J2.5
unnamed: INTAN32.53 (IN12), U$7.P$1
unnamed: INTAN32.51 (IN14), U$8.P$1
unnamed: INTAN32.49 (IN16), U$9.P$1
unnamed: INTAN32.47 (IN18), U$10.P$1
unnamed: INTAN32.45 (IN20), U$11.P$1
unnamed: INTAN32.43 (IN22), U$12.P$1
unnamed: INTAN32.41 (IN24), U$13.P$1
unnamed: INTAN32.39 (IN26), U$14.P$1
unnamed: INTAN32.37 (IN28), U$15.P$1
unnamed: INTAN32.35 (IN30), U$16.P$1
REF_ELEC: INTAN32.10 (REF_ELEC), REF_ELEC.P$1
VCC: BYPASS1.1, BYPASS2.1, INTAN32.13 (VDD1), INTAN32.26 (VDD2), INTAN32.31 (VDD3), J2.7

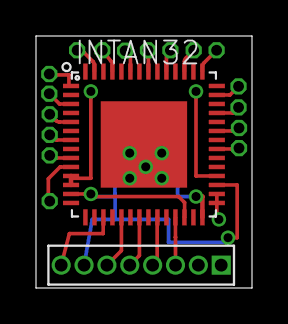
[picture p79: board Intan_32.brd from above]

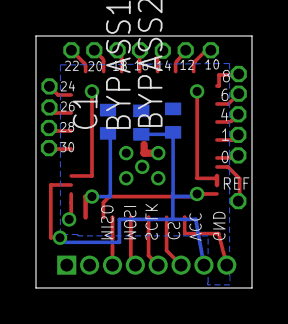
[picture p80: board Intan_32.brd from below]

Board: 2 copper layers, 12.0 x 14.0 mm, 22 parts (3 on the bottom side), 24 nets.
