JulianYG/WNR/documentation/PCB/PCB Designs v1/LVDS/LVDS.brd

## EAGLE design documentation/PCB/PCB Designs v1/LVDS/LVDS.brd (2016-05-17)

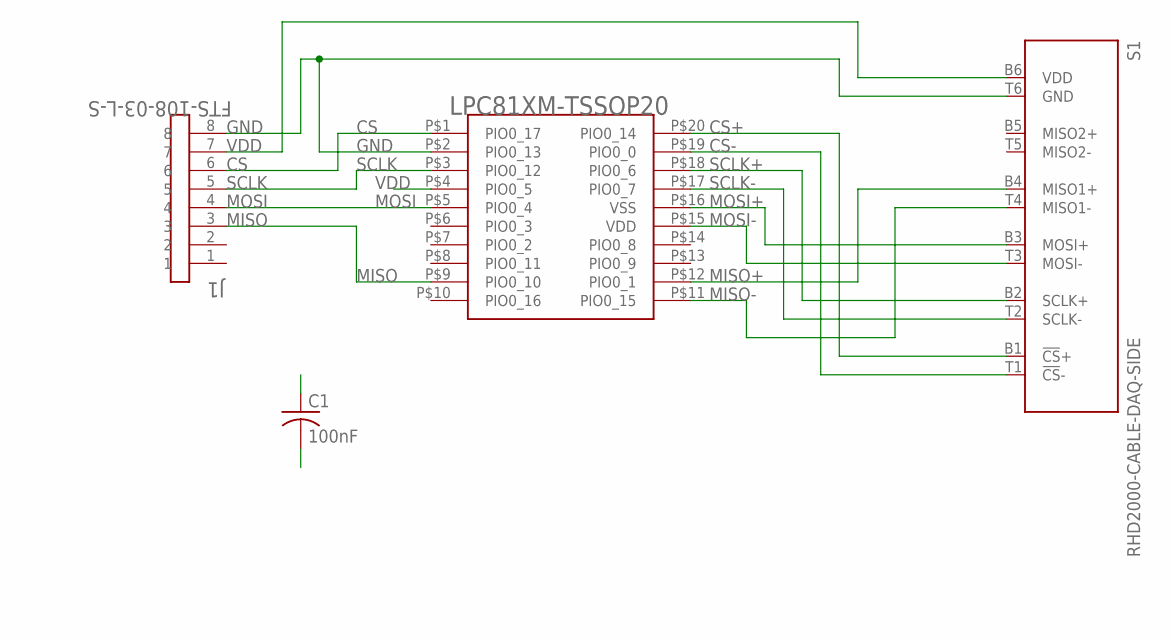
[picture p81: schematic LVDS.sch]

Parts:
C1: 100nF; C0402
J1: FTS-108-03-L-S; SAMTEC_FTS-108-03-S
LVDS: LPC81XM_TSSOP20; TSSOP20
S1: RHD2000-CABLE-DAQ-SIDE; OMNETICS_PZN-12-AA

Connections:
CS: J1.6, LVDS.P$1 (PIO0_17)
CS+: LVDS.P$20 (PIO0_14), S1.B1 (!CS!+)
CS-: LVDS.P$19 (PIO0_0), S1.T1 (!CS!-)
GND: C1.2, J1.8, LVDS.P$2 (PIO0_13), S1.T6 (GND)
MISO: J1.3, LVDS.P$9 (PIO0_10)
MISO+: LVDS.P$12 (PIO0_1), S1.B4 (MISO1+)
MISO-: LVDS.P$11 (PIO0_15), S1.T4 (MISO1-)
MOSI: J1.4, LVDS.P$5 (PIO0_4)
MOSI+: LVDS.P$16 (VSS), S1.B3 (MOSI+)
MOSI-: LVDS.P$15 (VDD), S1.T3 (MOSI-)
SCLK: J1.5, LVDS.P$3 (PIO0_12)
SCLK+: LVDS.P$18 (PIO0_6), S1.B2 (SCLK+)
SCLK-: LVDS.P$17 (PIO0_7), S1.T2 (SCLK-)
VDD: C1.1, J1.7, LVDS.P$4 (PIO0_5), S1.B6 (VDD)

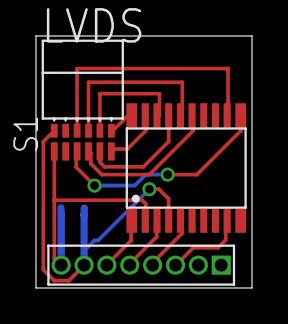
[picture p82: board LVDS.brd from above]

Board: 2 copper layers, 12.0 x 14.0 mm, 4 parts (1 on the bottom side), 14 nets.
