JulianYG/WNR/documentation/PCB/nrf52_pcb_layout.brd

## EAGLE design documentation/PCB/nrf52_pcb_layout.brd (2016-05-17)

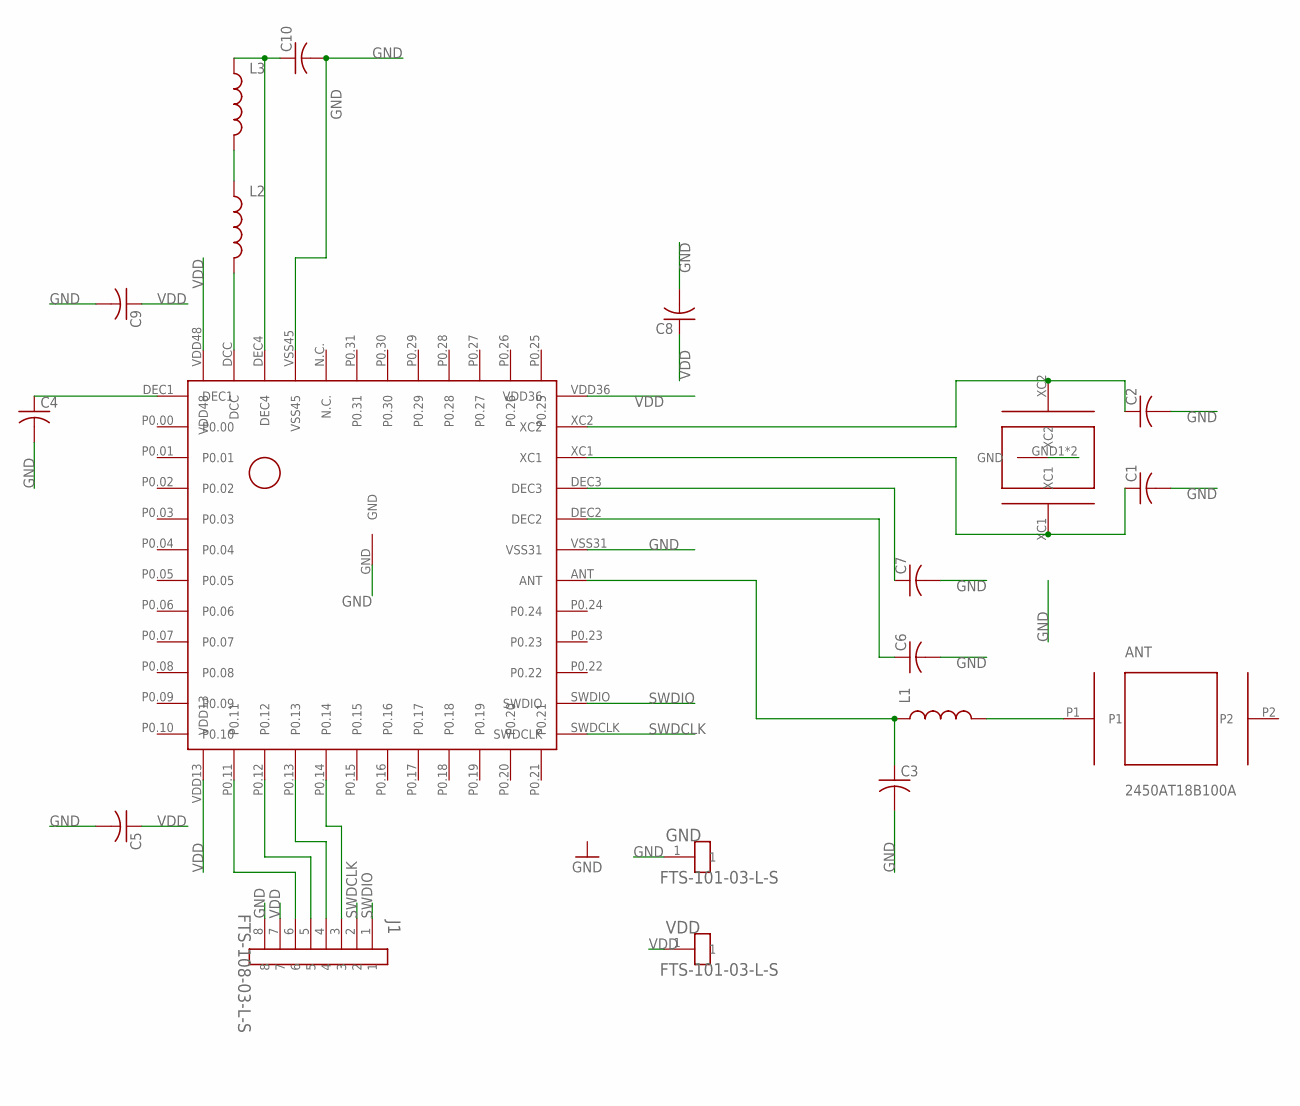
[picture p83: schematic nrf52_pcb_layout.sch]

Parts:
ANT: 2450AT18B100A; 2450AT18B100
C1, C2, C3, C4, C5, C6, C7, C8: C-USC0402; C0402
C9, C10: C-USC0603; C0603
GND: FTS-101-03-L-S; SAMTEC_FTS-101-03-S
J1: FTS-108-03-L-S; SAMTEC_FTS-108-03-S
L1, L3: INDUCTOR0402; C0402
L2: INDUCTOR0603; 0603
NRF52: NRF52832-QFN48
VDD: FTS-101-03-L-S; SAMTEC_FTS-101-03-S
X1: XTAL-SMD-2016SMD-2016; XTAL-SMD-2016

Connections:
GND: C1.2, C2.2, C3.2, C4.2, C5.2, C6.2, C7.2, C8.2, C9.2, C10.2, GND.1, J1.8, NRF52.GND, NRF52.VSS31, NRF52.VSS45, X1.GND1 (GND), X1.GND2 (GND)
unnamed: ANT.P1, L1.2
unnamed: L2.1, L3.2
unnamed: C4.1, NRF52.DEC1
unnamed: L2.2, NRF52.DCC
unnamed: C10.1, L3.1, NRF52.DEC4
unnamed: C2.1, NRF52.XC2, X1.XC2
unnamed: C1.1, NRF52.XC1, X1.XC1
unnamed: J1.6, NRF52.P0.11
unnamed: J1.5, NRF52.P0.12
unnamed: J1.4, NRF52.P0.13
unnamed: J1.3, NRF52.P0.14
unnamed: C3.1, L1.1, NRF52.ANT
unnamed: C7.1, NRF52.DEC3
unnamed: C6.1, NRF52.DEC2
SWDCLK: J1.2, NRF52.SWDCLK
SWDIO: J1.1, NRF52.SWDIO
VDD: C5.1, C8.1, C9.1, J1.7, NRF52.VDD13, NRF52.VDD36, NRF52.VDD48, VDD.1

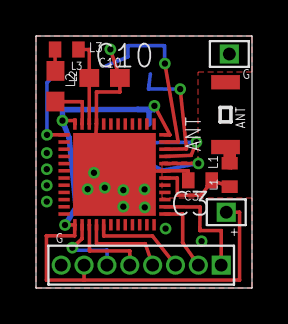
[picture p84: board nrf52_pcb_layout.brd from above]

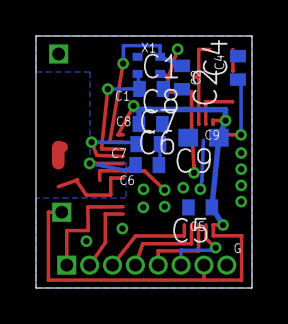
[picture p85: board nrf52_pcb_layout.brd from below]

Board: 2 copper layers, 12.0 x 14.0 mm, 19 parts (9 on the bottom side), 18 nets.
