JulianYG/WNR/documentation/PCB/PCB Designs v1/Battery/BatteryPCB2989.brd

## EAGLE design documentation/PCB/PCB Designs v1/Battery/BatteryPCB2989.brd (2016-05-17)

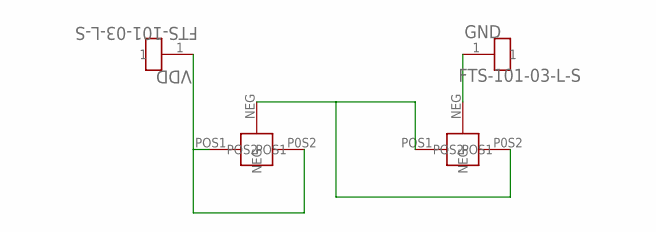
[picture p86: schematic BatteryPCB2989.sch]

Parts:
GND: FTS-101-03-L-S; SAMTEC_FTS-101-03-S
U$1, U$2: 2989NOHOLE
VDD: FTS-101-03-L-S; SAMTEC_FTS-101-03-S

Connections:
unnamed: U$1.NEG, U$2.P0S2 (POS2), U$2.POS1
unnamed: GND.1, U$2.NEG
unnamed: U$1.P0S2 (POS2), U$1.POS1, VDD.1

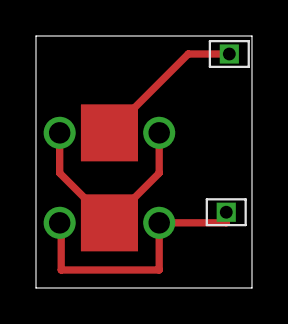
[picture p87: board BatteryPCB2989.brd from above]

Board: 2 copper layers, 12.0 x 14.0 mm, 4 parts (0 on the bottom side), 3 nets.
