JulianYG/WNR/documentation/PCB/PCB Designs v1/Battery_large/BatteryPCB2997.brd

## EAGLE design documentation/PCB/PCB Designs v1/Battery_large/BatteryPCB2997.brd (2016-05-17)


Parts:
GND: FTS-101-03-L-S; SAMTEC_FTS-101-03-S
U$3, U$4: 2997
VDD: FTS-101-03-L-S; SAMTEC_FTS-101-03-S

Connections:
unnamed: U$3.NEG, U$4.P0S2 (POS2), U$4.POS1
unnamed: GND.1, U$4.NEG
unnamed: U$3.P0S2 (POS2), U$3.POS1, VDD.1

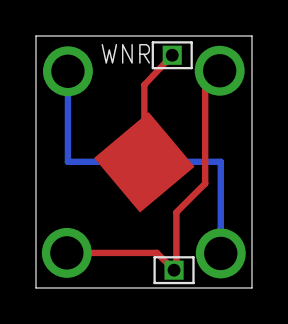
[picture p88: board BatteryPCB2997.brd from above]

Board: 2 copper layers, 12.0 x 14.0 mm, 4 parts (1 on the bottom side), 3 nets.
