JulianYG/WNR/nRF5_complete/examples/ble_central/complete_central/main.c

/*
 * Copyright (c) 2014 Nordic Semiconductor. All Rights Reserved.
 *
 * The information contained herein is confidential property of Nordic Semiconductor. The use,
 * copying, transfer or disclosure of such information is prohibited except by express written
 * agreement with Nordic Semiconductor.
 *
 */

/** @example Board/nrf6310/s120/experimental/ble_app_multilink_central/main.c
 *
 * @brief Multilink BLE application main file.
 *
 * This file contains the source code for a sample central connecting to maximum 8 Peripherals.
 */

#include <stdint.h>
#include <stdio.h>
#include <string.h>
#include "nordic_common.h"
#include "nrf_sdm.h"
#include "ble.h"
#include "client_handling.h"
#include "softdevice_handler.h"
#include "app_util.h"
#include "app_error.h"
#include "boards.h"
#include "nrf_gpio.h"
#include "pstorage.h"
#include "device_manager.h"
#include "bsp.h"
#include "bsp_btn_ble.h"
#include "app_trace.h"
#include "app_util.h"

#include "app_timer.h"
#include "app_uart.h"
#include "throughput.h"

#define CENTRAL_LINK_COUNT               DEVICE_MANAGER_MAX_CONNECTIONS                 /**<number of central links used by the application. When changing this number remember to adjust the RAM settings*/
#define PERIPHERAL_LINK_COUNT            0                                              /**<number of peripheral links used by the application. When changing this number remember to adjust the RAM settings*/

#define UART_TX_BUF_SIZE        256                             /**< UART TX buffer size. */
#define UART_RX_BUF_SIZE        256                             /**< UART RX buffer size. */

#ifdef BSP_BUTTON_1
#define BOND_DELETE_ALL_BUTTON_PIN       BSP_BUTTON_1                                   /**< Button used for deleting all bonded centrals during startup. */
#endif

#define APPL_LOG                         app_trace_log                                  /**< Debug logger macro that will be used in this file to do logging of debug information over UART. */

#define SEC_PARAM_BOND                   1                                              /**< Perform bonding. */
#define SEC_PARAM_MITM                   1                                              /**< Man In The Middle protection not required. */
#define SEC_PARAM_IO_CAPABILITIES        BLE_GAP_IO_CAPS_NONE                           /**< No I/O capabilities. */
#define SEC_PARAM_OOB                    0                                              /**< Out Of Band data not available. */
#define SEC_PARAM_MIN_KEY_SIZE           7                                              /**< Minimum encryption key size. */
#define SEC_PARAM_MAX_KEY_SIZE           16                                             /**< Maximum encryption key size. */

#define SCAN_INTERVAL                    0x00A0                                         /**< Determines scan interval in units of 0.625 millisecond. */
#define SCAN_WINDOW                      0x0050                                         /**< Determines scan window in units of 0.625 millisecond. */

#define APP_TIMER_PRESCALER     0                               /**< Value of the RTC1 PRESCALER register. */
#define APP_TIMER_OP_QUEUE_SIZE 2                               /**< Size of timer operation queues. */

#define MIN_CONNECTION_INTERVAL          MSEC_TO_UNITS(7.5, UNIT_1_25_MS)                /**< Determines minimum connection interval in millisecond. */
#define MAX_CONNECTION_INTERVAL          MSEC_TO_UNITS(7.5, UNIT_1_25_MS)                /**< Determines maximum connection interval in millisecond. */
#define SLAVE_LATENCY                    0                                              /**< Determines slave latency in counts of connection events. */
#define SUPERVISION_TIMEOUT              MSEC_TO_UNITS(4000, UNIT_10_MS)                /**< Determines supervision time-out in units of 10 millisecond. */

#define TARGET_DEV_NAME                  "Multilink_SX"                                    /**< Target device name that application is looking for. */

#define BLE_NUS_MAX_DATA_LEN 20  /** max number of bytes in one packet.  Temporarily defined; should use definition in ble_nus_c.h */

uint32_t counter = 0;

/**@brief Variable length data encapsulation in terms of length and pointer to data */
typedef struct
{
    uint8_t     * p_data;                                                      /**< Pointer to data. */
    uint16_t      data_len;                                                    /**< Length of data. */
}data_t;

static dm_application_instance_t          m_dm_app_id;                         /**< Application identifier. */
static uint8_t                            m_peer_count = 0;                    /**< Number of peer's connected. */

static bool                               m_memory_access_in_progress = false; /**< Flag to keep track of ongoing operations on persistent memory. */

/**
 * @brief Scan parameters requested for scanning and connection.
 */
static const ble_gap_scan_params_t m_scan_param =
{
     0,                       // Active scanning not set.
     0,                       // Selective scanning not set.
     NULL,                    // White-list not set.
     (uint16_t)SCAN_INTERVAL, // Scan interval.
     (uint16_t)SCAN_WINDOW,   // Scan window.
     0                        // Never stop scanning unless explicitly asked to.
};


/**
 * @brief Connection parameters requested for connection.
 */
static const ble_gap_conn_params_t m_connection_param =
{
    (uint16_t)MIN_CONNECTION_INTERVAL,   // Minimum connection
    (uint16_t)MAX_CONNECTION_INTERVAL,   // Maximum connection
    0,                                   // Slave latency
    (uint16_t)SUPERVISION_TIMEOUT        // Supervision time-out
};

static void scan_start(void);

/**@brief Function for asserts in the SoftDevice.
 *
 * @details This function will be called in case of an assert in the SoftDevice.
 *
 * @warning This handler is an example only and does not fit a final product. You need to analyze
 *          how your product is supposed to react in case of Assert.
 * @warning On assert from the SoftDevice, the system can only recover on reset.
 *
 * @param[in] line_num        Line number of the failing ASSERT call.
 * @param[in] p_file_name     File name of the failing ASSERT call.
 */
void assert_nrf_callback(uint16_t line_num, const uint8_t * p_file_name)
{
    app_error_handler(0xDEADBEEF, line_num, p_file_name);
}


/**@brief Callback handling device manager events.
 *
 * @details This function is called to notify the application of device manager events.
 *
 * @param[in]   p_handle      Device Manager Handle. For link related events, this parameter
 *                            identifies the peer.
 * @param[in]   p_event       Pointer to the device manager event.
 * @param[in]   event_status  Status of the event.
 */
static ret_code_t device_manager_event_handler(const dm_handle_t    * p_handle,
                                                 const dm_event_t     * p_event,
                                                 const ret_code_t     event_result)
{
    uint32_t       err_code;

    switch(p_event->event_id)
    {
        case DM_EVT_CONNECTION:
            APPL_LOG("[APPL]:[0x%02X] >> DM_EVT_CONNECTION\r\n", p_handle->connection_id);
//#ifdef ENABLE_DEBUG_LOG_SUPPORT
            ble_gap_addr_t * p_peer_addr;
            p_peer_addr = &p_event->event_param.p_gap_param->params.connected.peer_addr;
//#endif // ENABLE_DEBUG_LOG_SUPPORT
            //printf("[APPL]:[%02X %02X %02X %02X %02X %02X]: Connection Established\r\n",
            //                p_peer_addr->addr[0], p_peer_addr->addr[1], p_peer_addr->addr[2],
            //                p_peer_addr->addr[3], p_peer_addr->addr[4], p_peer_addr->addr[5]);
            //printf("\r\n");

            //printf("[APPL]:[CI 0x%02X]: Requesting GATT client create\r\n",
            //         p_handle->connection_id);
            err_code = client_handling_create(p_handle, p_event->event_param.p_gap_param->conn_handle);
            APP_ERROR_CHECK(err_code);

            m_peer_count++;
            if (m_peer_count < CENTRAL_LINK_COUNT)
            {
                scan_start();
            }
            //printf("[APPL]:[0x%02X] << DM_EVT_CONNECTION\r\n", p_handle->connection_id);
            break;
        case DM_EVT_DISCONNECTION:
            //printf("[APPL]:[0x%02X] >> DM_EVT_DISCONNECTION\r\n", p_handle->connection_id);

            err_code = client_handling_destroy(p_handle);
            APP_ERROR_CHECK(err_code);

            if (m_peer_count == CENTRAL_LINK_COUNT)
            {
                scan_start();
            }
            m_peer_count--;
            //printf("[APPL]:[0x%02X] << DM_EVT_DISCONNECTION\r\n", p_handle->connection_id);
						
						// Print the number of packets received.
						//printf("Packets received: %d", counter);
            break;
        case DM_EVT_SECURITY_SETUP:
        {
            dm_handle_t handle = (*p_handle);
            //printf("[APPL]:[0x%02X] >> DM_EVT_SECURITY_SETUP\r\n", p_handle->connection_id);
            // Slave securtiy request received from peer, if from a non bonded device,
            // initiate security setup, else, wait for encryption to complete.
            err_code = dm_security_setup_req(&handle);
            APP_ERROR_CHECK(err_code);
            //printf("[APPL]:[0x%02X] << DM_EVT_SECURITY_SETUP\r\n", p_handle->connection_id);
            break;
        }
        case DM_EVT_SECURITY_SETUP_COMPLETE:
            //printf("[APPL]:[0x%02X] >> DM_EVT_SECURITY_SETUP_COMPLETE, result 0x%08X\r\n",
             //         p_handle->connection_id, event_result);
            //printf("[APPL]:[0x%02X] << DM_EVT_SECURITY_SETUP_COMPLETE\r\n",
            //          p_handle->connection_id);
            break;
        case DM_EVT_LINK_SECURED:
            //printf("[APPL]:[0x%02X] >> DM_LINK_SECURED_IND, result 0x%08X\r\n",
            //          p_handle->connection_id, event_result);
            //printf("[APPL]:[0x%02X] << DM_LINK_SECURED_IND\r\n", p_handle->connection_id);
            break;
        case DM_EVT_DEVICE_CONTEXT_LOADED:
            //printf("[APPL]:[0x%02X] >> DM_EVT_LINK_SECURED\r\n", p_handle->connection_id);
            APP_ERROR_CHECK(event_result);
            //printf("[APPL]:[0x%02X] << DM_EVT_DEVICE_CONTEXT_LOADED\r\n", p_handle->connection_id);
            break;
        case DM_EVT_DEVICE_CONTEXT_STORED:
            //printf("[APPL]:[0x%02X] >> DM_EVT_DEVICE_CONTEXT_STORED\r\n", p_handle->connection_id);
            APP_ERROR_CHECK(event_result);
            //printf("[APPL]:[0x%02X] << DM_EVT_DEVICE_CONTEXT_STORED\r\n", p_handle->connection_id);
            break;
        case DM_EVT_DEVICE_CONTEXT_DELETED:
            //printf("[APPL]:[0x%02X] >> DM_EVT_DEVICE_CONTEXT_DELETED\r\n", p_handle->connection_id);
            APP_ERROR_CHECK(event_result);
            //printf("[APPL]:[0x%02X] << DM_EVT_DEVICE_CONTEXT_DELETED\r\n", p_handle->connection_id);
            break;
        default:
            break;
    }

    // Relay the event to client handling module.
    err_code = client_handling_dm_event_handler(p_handle, p_event, event_result);
    APP_ERROR_CHECK(err_code);

    return NRF_SUCCESS;
}

/**
 * @brief Parses advertisement data, providing length and location of the field in case
 *        matching data is found.
 *
 * @param[in]  Type of data to be looked for in advertisement data.
 * @param[in]  Advertisement report length and pointer to report.
 * @param[out] If data type requested is found in the data report, type data length and
 *             pointer to data will be populated here.
 *
 * @retval NRF_SUCCESS if the data type is found in the report.
 * @retval NRF_ERROR_NOT_FOUND if the data type could not be found.
 */
static uint32_t adv_report_parse(uint8_t type, data_t * p_advdata, data_t * p_typedata)
{
    uint32_t index = 0;
    uint8_t * p_data;

    p_data = p_advdata->p_data;

    while (index < p_advdata->data_len)
    {
        uint8_t field_length = p_data[index];
        uint8_t field_type   = p_data[index+1];

        if (field_type == type)
        {
            p_typedata->p_data   = &p_data[index+2];
            p_typedata->data_len = field_length-1;
            return NRF_SUCCESS;
        }
        index += field_length+1;
    }
    return NRF_ERROR_NOT_FOUND;
}


/**@brief Function for handling the Application's BLE Stack events.
 *
 * @param[in]   p_ble_evt   Bluetooth stack event.
 */
static void on_ble_evt(ble_evt_t * p_ble_evt)
{
    uint32_t        err_code;

    switch (p_ble_evt->header.evt_id)
    {
        case BLE_GAP_EVT_ADV_REPORT:
        {
            data_t adv_data;
            data_t type_data;
            
					  //printf("ble BLE_GAP_EVT_ADV_REPORT\r\n");
            // Initialize advertisement report for parsing.
            adv_data.p_data = p_ble_evt->evt.gap_evt.params.adv_report.data;
            adv_data.data_len = p_ble_evt->evt.gap_evt.params.adv_report.dlen;

            err_code = adv_report_parse(BLE_GAP_AD_TYPE_COMPLETE_LOCAL_NAME,
                                      &adv_data,
                                      &type_data);
            if (err_code != NRF_SUCCESS)
            {
                // Compare short local name in case complete name does not match.
                err_code = adv_report_parse(BLE_GAP_AD_TYPE_SHORT_LOCAL_NAME,
                                          &adv_data,
                                          &type_data);
            }

            // Verify if short or complete name matches target.
            if ((err_code == NRF_SUCCESS) &&
               (0 == memcmp(TARGET_DEV_NAME,type_data.p_data,type_data.data_len)))
            {
                err_code = sd_ble_gap_scan_stop();
                if (err_code != NRF_SUCCESS)
                {
                    APPL_LOG("[APPL]: Scan stop failed, reason %d\r\n", err_code);
                }

                err_code = sd_ble_gap_connect(&p_ble_evt->evt.gap_evt.params.adv_report.\
                                              peer_addr,
                                              &m_scan_param,
                                              &m_connection_param);

                if (err_code != NRF_SUCCESS)
                {
                    APPL_LOG("[APPL]: Connection Request Failed, reason %d\r\n", err_code);
                }
            }
            break;
        }
        case BLE_GAP_EVT_TIMEOUT:
					  //printf("ble BLE_GAP_EVT_TIMEOUT\r\n");
            if(p_ble_evt->evt.gap_evt.params.timeout.src == BLE_GAP_TIMEOUT_SRC_SCAN)
            {
                APPL_LOG("[APPL]: Scan Timedout.\r\n");
            }
            else if (p_ble_evt->evt.gap_evt.params.timeout.src == BLE_GAP_TIMEOUT_SRC_CONN)
            {
                APPL_LOG("[APPL]: Connection Request Timedout.\r\n");
            }
            break;
        default:
            break;
    }
}


/**@brief Function for handling the Application's system events.
 *
 * @param[in]   sys_evt   system event.
 */
static void on_sys_evt(uint32_t sys_evt)
{
    switch(sys_evt)
    {
        case NRF_EVT_FLASH_OPERATION_SUCCESS:
        case NRF_EVT_FLASH_OPERATION_ERROR:
            if (m_memory_access_in_progress)
            {
                m_memory_access_in_progress = false;
                scan_start();
            }
            break;
        default:
            // No implementation needed.
            break;
    }
}


/**@brief Function for dispatching a BLE stack event to all modules with a BLE stack event handler.
 *
 * @details This function is called from the scheduler in the main loop after a BLE stack event has
 *  been received.
 *
 * @param[in] p_ble_evt     Bluetooth stack event.
 */
static void ble_evt_dispatch(ble_evt_t * p_ble_evt)
{
	  dm_ble_evt_handler(p_ble_evt);
    client_handling_ble_evt_handler(p_ble_evt);   
    on_ble_evt(p_ble_evt);
	  //printf("EVT: %d\r\n", p_ble_evt->header.evt_id);
}


/**@brief Function for dispatching a system event to interested modules.
 *
 * @details This function is called from the System event interrupt handler after a system
 *          event has been received.
 *
 * @param[in]   sys_evt   System stack event.
 */
static void sys_evt_dispatch(uint32_t sys_evt)
{
    pstorage_sys_event_handler(sys_evt);
    on_sys_evt(sys_evt);
}

/**@brief   Function for handling app_uart events.
 *
 * @details This function will receive a single character from the app_uart module and append it to 
 *          a string. The string will be be sent over BLE when the last character received was a 
 *          'new line' i.e '\n' (hex 0x0D) or if the string has reached a length of 
 *          @ref NUS_MAX_DATA_LENGTH.
 */
void uart_event_handle(app_uart_evt_t * p_event)
{
    static uint8_t data_array[BLE_NUS_MAX_DATA_LEN];
    static uint8_t index = 0;

    switch (p_event->evt_type)
    {
        /**@snippet [Handling data from UART] */ 
        case APP_UART_DATA_READY:
            UNUSED_VARIABLE(app_uart_get(&data_array[index]));
            index++;

/*
            if ((data_array[index - 1] == '\n') || (index >= (BLE_NUS_MAX_DATA_LEN)))
            {
                while (ble_nus_c_string_send(&m_ble_nus_c, data_array, index) != NRF_SUCCESS)			
                {
                    // repeat until sent
                }
                index = 0;
            }
				*/
            break;
        /**@snippet [Handling data from UART] */ 
        case APP_UART_COMMUNICATION_ERROR:
            APP_ERROR_HANDLER(p_event->data.error_communication);
            break;

        case APP_UART_FIFO_ERROR:
            APP_ERROR_HANDLER(p_event->data.error_code);
            break;

        default:
            break;
    }
}

/**@brief Function for initializing the BLE stack.
 *
 * @details Initializes the SoftDevice and the BLE event interrupt.
 */
static void ble_stack_init(void)
{
    uint32_t err_code;

    // Initialize the SoftDevice handler module.
    SOFTDEVICE_HANDLER_INIT(NRF_CLOCK_LFCLKSRC_XTAL_20_PPM, NULL);
    
    ble_enable_params_t ble_enable_params;
    err_code = softdevice_enable_get_default_config(CENTRAL_LINK_COUNT,
                                                    PERIPHERAL_LINK_COUNT,
                                                    &ble_enable_params);
    APP_ERROR_CHECK(err_code);
    
    //Check the ram settings against the used number of links
    CHECK_RAM_START_ADDR(CENTRAL_LINK_COUNT,PERIPHERAL_LINK_COUNT);
    
    // Enable BLE stack.
    err_code = softdevice_enable(&ble_enable_params);
    APP_ERROR_CHECK(err_code);

    // Register with the SoftDevice handler module for BLE events.
    err_code = softdevice_ble_evt_handler_set(ble_evt_dispatch);
    APP_ERROR_CHECK(err_code);

    // Register with the SoftDevice handler module for BLE events.
    err_code = softdevice_ble_evt_handler_set(ble_evt_dispatch);
    APP_ERROR_CHECK(err_code);

    // Register with the SoftDevice handler module for System events.
    err_code = softdevice_sys_evt_handler_set(sys_evt_dispatch);
    APP_ERROR_CHECK(err_code);
}


/**@brief Function for initializing the Device Manager.
 *
 * @details Device manager is initialized here.
 */
static void device_manager_init(void)
{
    dm_application_param_t param;
    dm_init_param_t        init_param;

    uint32_t err_code;

    err_code = pstorage_init();
    APP_ERROR_CHECK(err_code);

    init_param.clear_persistent_data = false;

#ifdef BOND_DELETE_ALL_BUTTON_PIN
    // Clear all bonded devices if user requests to.
    init_param.clear_persistent_data =
        ((nrf_gpio_pin_read(BOND_DELETE_ALL_BUTTON_PIN) == 0)? true: false);
#endif

    err_code = dm_init(&init_param);
    APP_ERROR_CHECK(err_code);

    memset(&param.sec_param, 0, sizeof (ble_gap_sec_params_t));

    // Event handler to be registered with the module.
    param.evt_handler            = device_manager_event_handler;

    // Service or protocol context for device manager to load, store and apply on behalf of application.
    // Here set to client as application is a GATT client.
    param.service_type           = DM_PROTOCOL_CNTXT_GATT_CLI_ID;

    // Secuirty parameters to be used for security procedures.
    param.sec_param.bond         = SEC_PARAM_BOND;
    param.sec_param.mitm         = SEC_PARAM_MITM;
    param.sec_param.io_caps      = SEC_PARAM_IO_CAPABILITIES;
    param.sec_param.oob          = SEC_PARAM_OOB;
    param.sec_param.min_key_size = SEC_PARAM_MIN_KEY_SIZE;
    param.sec_param.max_key_size = SEC_PARAM_MAX_KEY_SIZE;
    param.sec_param.kdist_periph.enc = 1;
    param.sec_param.kdist_periph.id  = 1;

    err_code = dm_register(&m_dm_app_id,&param);
    APP_ERROR_CHECK(err_code);
}


/**@brief Function for initializing the button handler module.
 */
static void buttons_init(void)
{
#ifdef BOND_DELETE_ALL_BUTTON_PIN
  	// Set Wakeup and Bonds Delete buttons as wakeup sources.
    nrf_gpio_cfg_sense_input(BOND_DELETE_ALL_BUTTON_PIN,
                             BUTTON_PULL,
                             NRF_GPIO_PIN_SENSE_LOW);
#endif
}

/** Initialize timers
*/
static void timers_init(void)
{
	APP_TIMER_INIT(APP_TIMER_PRESCALER, APP_TIMER_OP_QUEUE_SIZE, NULL);
}

/**@brief Function for initializing the UART.
 */
static void uart_init(void)
{
    uint32_t err_code;

    const app_uart_comm_params_t comm_params =
      {
        .rx_pin_no    = RX_PIN_NUMBER,
        .tx_pin_no    = TX_PIN_NUMBER,
        .rts_pin_no   = RTS_PIN_NUMBER,
        .cts_pin_no   = CTS_PIN_NUMBER,
        .flow_control = APP_UART_FLOW_CONTROL_ENABLED,
        .use_parity   = false,
        .baud_rate    = UART_BAUDRATE_BAUDRATE_Baud38400
      };

    APP_UART_FIFO_INIT(&comm_params,
                        UART_RX_BUF_SIZE,
                        UART_TX_BUF_SIZE,
                        uart_event_handle,
                        APP_IRQ_PRIORITY_LOW,
                        err_code);

    APP_ERROR_CHECK(err_code);
}


/**@brief Function for the Power manager.
 */
static void power_manage(void)
{
    uint32_t err_code = sd_app_evt_wait();
    APP_ERROR_CHECK(err_code);
}

/**@breif Function to start scanning.
 */
static void scan_start(void)
{
    uint32_t err_code;
    uint32_t count;
    // Verify if there is any flash access pending, if yes delay starting scanning until
    // it's complete.
    err_code = pstorage_access_status_get(&count);
    APP_ERROR_CHECK(err_code);

    if (count != 0)
    {
        m_memory_access_in_progress = true;
        return;
    }
    err_code = sd_ble_gap_scan_start(&m_scan_param);
    APP_ERROR_CHECK(err_code);
}

/**@brief Function for application main entry.
 */
int main(void)
{
    // Initialization of various modules.
    app_trace_init();
	  uart_init();
//	  printf("uart init \r\n");
	  timers_init();
//	  printf("timers init\r\n");
    LEDS_CONFIGURE(LEDS_MASK);
    LEDS_OFF(LEDS_MASK);
    buttons_init();
//	  printf("buttons init\r\n");
    ble_stack_init();
//	  printf("ble init\r\n");
    client_handling_init();
//	  printf("client handling init\r\n");
    device_manager_init();
//	  printf("device_manager init\r\n");

    // Start scanning for devices.
    scan_start();
//	  printf("main scan started\r\n");

    for (;;)
    {
        power_manage();
    }
}
