JulianYG/WNR/nRF5_comp_spi/examples/peripheral/Intan32/heatshrink/heatshrink/ble_data_buffer.h

#include <stdio.h>
#include <stdint.h>
#include <stdlib.h>
#include <string.h>
#include "app_error.h"
#include "nrf.h"
#include "bsp.h"
#include "heatshrink_encoder.h"
#include "heatshrink_decoder.h"
#include "heatshrink_config.h"

#define BUFFER_EMPTY 1
#define BUFFER_SUCCESS 0
#define BUFFER_FULL 2
#define BUFFER_ERROR -1

typedef struct data_buffer
{
	void *buffer;	// data buffer
	void *buffer_end;	// end of data buffer
	size_t cap;	// capacity of the buffer
	size_t item_cnt;	// number of items in the buffer
	size_t item_size;	// size of the item in the buffer
	void *head;	// pointer to the head
	void *tail;	// pointer to the tail
} data_buffer;

typedef struct wnr_data
{
	uint8_t *data;
	size_t size;
	int channel_num;
} wnr_data;

static heatshrink_encoder hse;

void buffer_init(data_buffer *db, size_t maxCap, size_t sz);
void buffer_free(data_buffer *db);
void buffer_reset(data_buffer *db);
int buffer_in(data_buffer *db, const void *item);
int buffer_poll(data_buffer *db, void *item);
int buffer_compress(uint8_t *db, size_t length, uint8_t *cb);
