JulianYG/WNR/(commit log)

2016-01-20 Initial commit for UART compression
    Make sure copy all files in uart folder to the lib folder under
    components/libraries/uart
2016-01-23 Add modified BLE uart example.
2016-02-15 Add the nRF52 throughput test project that was missing in the previous commit.
    [main.c, nrf_drv_config.h]
2016-02-25 heat shrink
2016-03-08 Add Intan SPI code
2016-03-12 Add SPI + Compression sdk
2016-04-06 with receiver and not working C
    [client_handling.c, heatshrink_config.h, heatshrink_decoder.c, main.c, nrf_drv_config.h, receiver.py]
2016-04-13 writign to csv
    [data.csv]
2016-04-13 working uart decomp
    [data.csv]
2016-04-13 should be workign BLE decomp
    [data.csv]
2016-04-14 workign ble
    [data.csv]
2016-04-14 purged repo
    [data.csv]
2016-05-17 Add demo testing code and documentation from Google Drive accumulated from the 2015 - 2016 academic school year.
    [BatteryPCB2989.brd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]
